TheChatou/lif3d-poc2d/docs/matos/S46a3821951794acbb375fb2ea09c03bbg.png

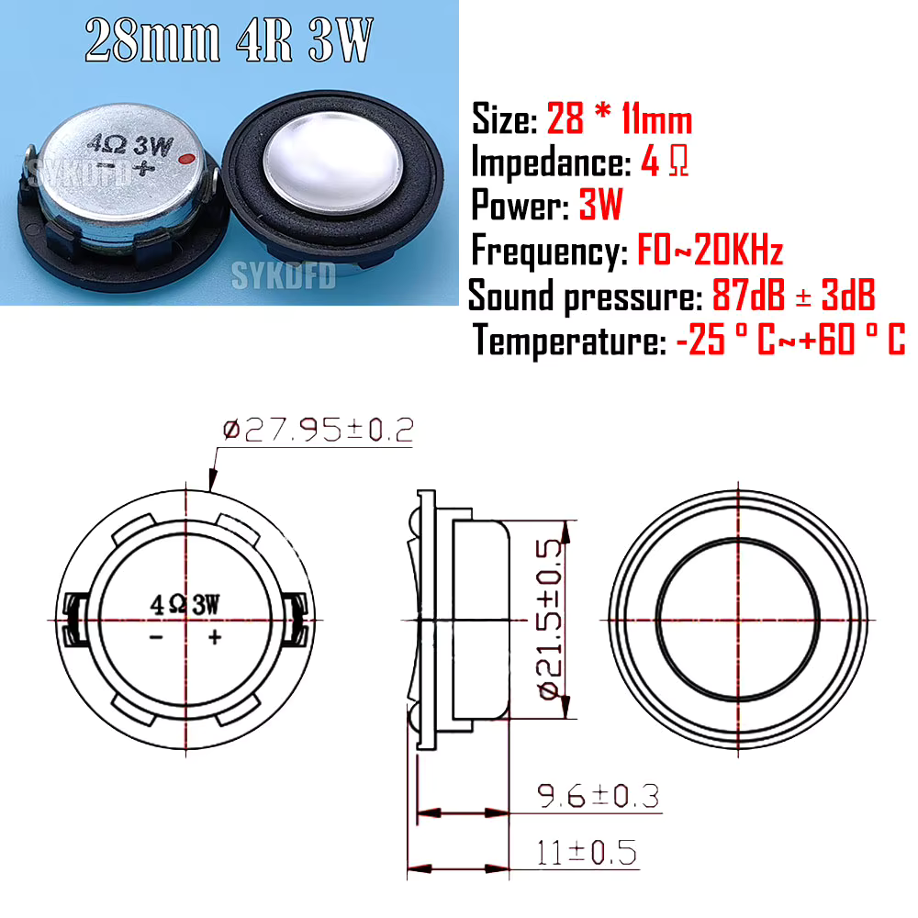
docs/matos/S46a3821951794acbb375fb2ea09c03bbg.png
