TheChatou/lif3d-poc2d/docs/media/photos/20261024_schema_cablage_asbuilt.jpg

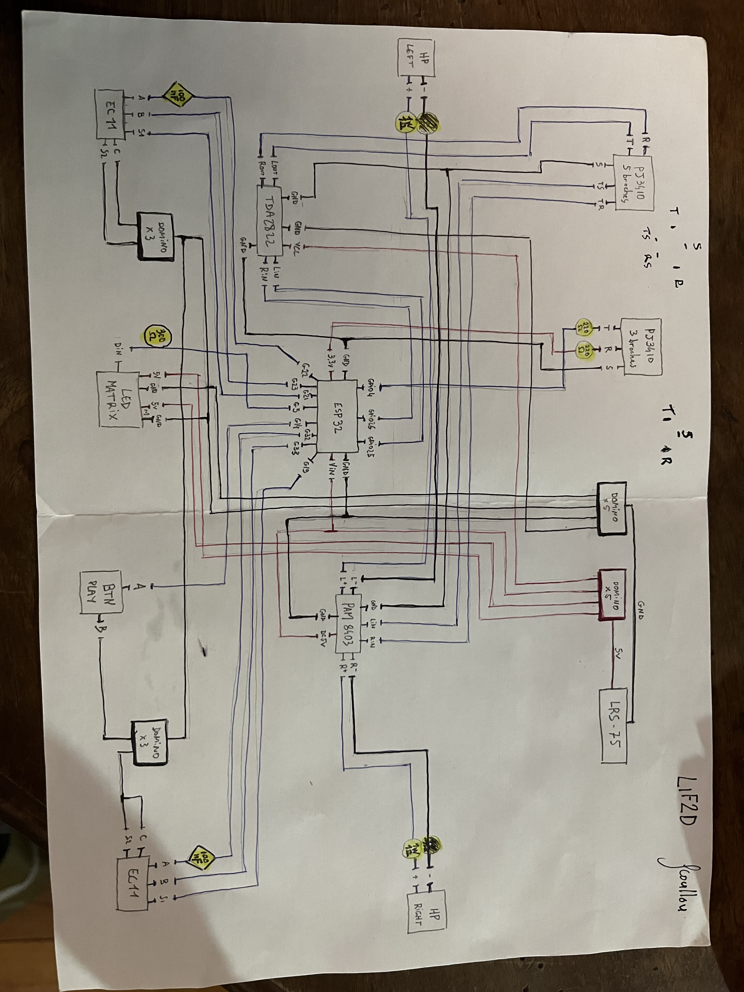
docs/media/photos/20261024_schema_cablage_asbuilt.jpg
