TheChatou/lif3d-poc2d/docs/progress.md

# LIF2D — Journal de progression

---

## 2026-06-02 — Première session lab, setup hardware

**Fait :**
- État des lieux complet du projet (firmware, simulateur, matos)
- Création du skill `/sim` (lance le simulateur depuis Claude Code)
- Création du skill `/log-session` (documente les sessions)
- Correction bug `sim.py` ligne 1013 — `v` parasite causant un IndentationError
- Mise à jour CLAUDE.md : MCU confirmé ESP32-D, hardware reçu listé, gamme Japonaise en priorité, paramètres son validés
- Inventaire hardware : perso (ESP32-D, WS2812B, PAM8403 HW-894 BT5.0, HP 4Ω ×2, alim 12V/2A) + lab (LM2596S)
- Brief fonctionnel rédigé pour Claude Design (`docs/BRIEF_DESIGN.md`)
- Guide de montage complet rédigé (`docs/TUTO_MONTAGE.md`)
- **LM2596S calé à 5.0V** au multimètre — DC Power Supply NANKADF réglé à 12V/1A, multimètre V— range 20V sur OUT+ / OUT−

**Décisions :**
- Utiliser le LM2596S du lab (3A) plutôt que le HX Mini 360 (1.8A) — plus de marge pour les LEDs
- Alimentation tests : DC Power Supply NANKADF (lab) en 12V → LM2596S → 5V, pas le BF-1220 (nécessite adaptateur barrel jack)
- Brief Claude Design : zéro prescription UX, laisser imaginer librement à partir des fonctionnalités + contexte physique

**Prochaines étapes :**
- [ ] Étape 2 — Premier test ESP32-D seul (blink + Serial Monitor)
- [ ] Étape 3 — Premier allumage WS2812B
- [ ] Étape 4 — Test audio PAM8403
- [ ] Lancer Claude Design avec le brief

**Hardware présent au lab :**
ESP32-D, WS2812B 16×16, PAM8403 HW-894, HP 4Ω ×2, alim 12V/2A BF-1220, LM2596S (lab), DC Power Supply NANKADF (lab), multimètre (lab)

---
## 2026-09-14 — FreeCAD merges + config.h finalisé

**Fait :**
- FreeCAD : chanfrein 1mm haut+bas créé proprement sur les 2 caches-boutons (Extrude117/118_zigzag), anciens objets cassés/orphelins nettoyés
- FreeCAD : nouveau support générique 30×45mm créé dans le style de support_pam (sans le cut cylindrique)
- FreeCAD : ouverture du connecteur PJ3412 élargie de 0.1mm (puis annulée sur demande)
- FreeCAD : objet `PJ3411` (hiérarchie App::Part imbriquée, 12 objets) supprimé — invisible/inutile
- FreeCAD : `POWER HOLDER` réparé (sketch source avec cercle+rectangle qui se chevauchaient au lieu d'une silhouette unique — auto-intersection corrigée)
- FreeCAD : `Compound002` "Glissière" fusionné proprement (n'était que compoundé, jamais vraiment fusionné)
- FreeCAD : **`FULL_BOTTOM_pour_impression`** et **`FULL_TOP_pour_impression`** créés — coques + tous les supports internes, chacun 1 seul solide valide, prêts pour export STL/Bambu
- `include/config.h` mis à jour : design final 2 encodeurs (`ENC_A`/`ENC_B`, ex-X/Y) + 1 bouton play/pause confirmé et câblé en dur ; ancien `ENC_VOL` (GPIO16/17/18) et `SW_ONOFF` (GPIO13) supprimés ; résistances/condensateurs documentés en constantes
- Schéma de câblage complet publié en artefact (signal GPIO + alimentation 5V/GND dédiée), mis à jour au fil de la session avec TDA2822, IEC Huaconn, LRS-75-5, MIDI Clock/MIDI IN prévu

**Décisions :**
- Design contrôleurs définitivement tranché : 1 bouton + 2 encodeurs génériques (plus de rôle fixe volume/X/Y), tout le paramétrage via menu sur la matrice LED
- GPIO13, 16, 17, 18 officiellement libérés, ne plus les câbler
- Les 2 pièces FreeCAD à problème étaient réparables sans perte de design (pas besoin de repartir de zéro)

**Problèmes rencontrés :**
- `Part::Boolean` (Fuse/MultiFuse) plante avec `Standard_NullObject` sur certains objets multi-solides (Extrude126/127) — contournement : fusion brute via `Shape.fuse()` + `removeSplitter()` en Python plutôt que la commande GUI
- `POWER HOLDER` et `Compound002` avaient des défauts géométriques non visibles via `isValid()` seul — nécessite `Shape.check(True)` pour les détecter (auto-intersections BOP)
- Décalage d'attache (`AttachmentOffset`) sur un Sketch : le repère local d'une face peut être inversé par rapport au Z global — toujours vérifier le `Placement` résultant, pas juste le signe de l'offset

**Prochaines étapes :**
- [ ] Export STL des deux pièces fusionnées + slicing Bambu
- [ ] Décider si `POWER HOLDER` doit être revu en profondeur ou si la réparation suffit à long terme
- [ ] Continuer `src/controls.cpp` (2 encodeurs + bouton) maintenant que les GPIO sont figés
- [ ] Câbler MIDI IN si le H11L1 est commandé/reçu (voir `docs/analyses/20260911_io_audio_midi_reflexion.md`)

**Hardware présent :** inchangé depuis les dernières sessions (voir mémoire projet `project_hardware.md`) — rien de nouveau reçu cette session, uniquement du travail CAO + firmware/doc.

---
## 2026-10-24 — Hardware terminé, début de la phase software

**Fait (entre le 15/09 et le 24/10, hors sessions Claude) :**
- Chronologie (précisée par Felix) : **août** modélisation à la maison → **fin août / début sept.** au Lab, finalisation modélisation + tests d'impression → **semaine du 14/09** impression de toutes les pièces → **nuit du 18 ou 19/09** soudure et câblage complet (le lendemain : incident matrice) → **départ en woofing** → **~11/10** réception et soudure de la nouvelle matrice → **24/10** reprise, phase software
- **Boîtier LIF2D entièrement assemblé et fonctionnel** (impression, soudure, câblage complet) — terminé avant le départ de Paris
- Le firmware de test (affichage chiffres/texte/glider) tourne déjà sur l'ESP32 — matrice, police 3×5 et boîtier validés visuellement
- Matrice WS2812B **rachetée** (voir incident ci-dessous)
- Schéma de câblage as-built dessiné à la main + photos → `docs/photos/` (renommées `20261024_*`, copies `.jpg` ajoutées)
- Vérification schéma ↔ `include/config.h` : **les 15 connexions ESP32 correspondent** (GPIO 4, 5, 14, 19, 21, 22, 23, 25, 26, 32, 33 + VIN/GND/3.3V/GND). Seul le commentaire de la section AUDIO était obsolète (chaîne DAC → TDA2822 → jack 5 broches → PAM8403) — corrigé
- MIDI OUT confirmé conforme TRS **Type A** (Tip = data GPIO4 via 220Ω, Ring = 3.3V via 220Ω, Sleeve = GND)
- Nouveau document : `docs/analyses/20261024_ui_grammaire_controles.md` (inventaire des gestes, types d'écrans, premier jet des réglages)

**Incident — matrice à moitié morte (retour d'expérience) :**
- Contexte : soudure jusqu'à 4h du matin, matrice qui ne s'allumait pas. Le lendemain, debug au multimètre en touchant (en tremblant) les soudures 5V/GND de la réinjection de courant au centre de la matrice. 5 min après : découverte que le fil DATA n'était pas sur la bonne broche de l'ESP32 — c'était la vraie cause du "rien ne s'allume". Résultat : seule la moitié de la matrice fonctionnait.
- Cause probable : la pointe de touche a ponté un pad 5V avec un pad DIN/DOUT voisin → la LED au milieu de la chaîne a grillé, et comme chaque WS2812B retransmet le signal à la suivante, **toute la suite de la chaîne est morte**.
- Leçons :
  1. **Vérifier d'abord le câblage logique (broche DATA, GND commun) avant de mesurer sous tension** — une erreur de broche ne grille rien, une pointe qui glisse oui.
  2. Mesurer **hors tension** (continuité) dès que possible ; sous tension, utiliser des pinces crocodiles plutôt que des pointes tenues à la main sur des pads serrés.
  3. Ne pas debugger fatigué.
  4. 💡 La vieille matrice est probablement **réparable** : une moitié morte = souvent **une seule LED grillée** à la frontière. Remplacer cette LED (5050, en stock sur AliExpress) ou ponter DIN→DOUT sur elle = matrice de rechange.

**Points hardware à confirmer :**
- ~~Condos 100µF sortie TDA2822~~ → résolu : intégrés au module (2 condos 100µF visibles devant les bornes de sortie)
- Son strident : dépend des volumes réglés sur les potards des amplis — baissés pour l'instant ; tests de gain TDA2822/PAM8403 à faire (étape 5)
- ~~Sortie HP− : symbole hachuré~~ → résolu : erreur de dessin, la résistance 1Ω est bien montée côté + (conforme)
- Affectation exacte A/B/clic de chaque encodeur : à valider avec un test (le sens de rotation s'inverse en logiciel si besoin)

**Décisions :**
- Phase suivante = **software**, en commençant par la conception UI : inventaire des réglages + grammaire de gestes + simulateur **web** fidèle au boîtier (photos + FreeCAD)
- Logique des menus écrite de façon portable pour finir en C++ sur l'ESP32 (une seule source de vérité)
- Test par une personne extérieure : plus tard, une fois la maquette jouable

**Prochaines étapes :**
- [ ] Séance de conception : trancher les questions de `20261024_ui_grammaire_controles.md` §6
- [ ] Compléter l'inventaire des réglages (§5)
- [ ] Simulateur web : rendu du boîtier réel + matrice + 2 molettes + bouton ▶
- [ ] Puis firmware : `controls.cpp` (encodeurs), `menu`, sauvegarde NVS

---
## 2026-10-25 — Premier firmware de test des menus (`ui_test`) sur la boîte

**Fait :**
- Firmware `ui_test` (env PlatformIO séparé, sans son) : modules réutilisables `src/ui/` (polices, affichage, entrées, hub, pages de réglages, BOOM, presets, DIAG) + `test_ui/main.cpp` ; polices générées depuis `tools/fonts_src.py` par `tools/gen_fonts.py`
- Orientation de la matrice validée : `ORIENT_TRANSPOSE = 1` seul (`src/ui/display.cpp`)
- DAC fixé à mi-tension quand il n'y a pas de son → plus d'entrée d'ampli flottante
- Fiche interférences : `docs/analyses/20261025_interferences_leds_audio.md`

**Problèmes rencontrés :**
- ⚠️ **Matrice toute blanche au 1er flash** : FastLED non figé (`^3.6.0`) → nouvel env a pris la 3.10.8. Corrigé : `ui_test` figé sur **FastLED 3.10.3** (version validée). Ajout d'une image de sécurité (1 LED rouge 2 s) + luminosité 20 au démarrage
- ⚠️ **Flash qui échoue + USB qui alimente toute la boîte** : secteur coupé, le 5 V USB ressort par VIN et alimente matrice + amplis → le port s'écroule. **Procédure de flash** : débrancher le fil VIN de l'ESP32 (garder GND), USB pour l'ESP32 seul, secteur pour le reste. Jamais USB + VIN branchés ensemble. Rebrancher VIN pour l'usage autonome
- ⚠️ **Molettes : la rotation ne fait rien** (clics OK). Diagnostic par mouchard série : les broches A (GPIO22, GPIO32) restent à 1 en permanence, seules les B bougent. **Cause : condensateur 100 nF câblé EN SÉRIE sur le fil A** (au lieu d'entre A et GND), sur les 2 encodeurs. **Réparation** : retirer le condo et rejoindre les 2 bouts de fil (Wago/domino, pas besoin de souder) ; le condo est facultatif (décodeur à table = anti-rebond logiciel), sinon le mettre entre A et C (GND) de l'encodeur. En attendant : `ENC_SINGLE_CHANNEL 1` dans `src/ui/input.cpp` (tourner = +1, tourner molette enfoncée = −1) → **remettre à 0 après réparation**
- Bruit audio corrélé à l'affichage des LEDs, surtout sur un HP → matériel (condensateurs / masses), mis de côté (voir fiche)

**Retours UX de Felix :**
- Les pages de réglages en "lignes de LEDs" n'ont pas été comprises (vues figées faute de rotation) → retester une fois la navigation possible ; variante prévue : réglage sélectionné en grand (nom + valeur), lignes en repère discret
- Bilan Felix (fin de session) : "pas mal dans l'ensemble, plus ou moins ce que j'avais en tête". Déplacement dans les presets peu pratique (aggravé par le mode dépannage 1 contact) ; quelques petits bugs ressentis → à lister à la prochaine session

**Réparation encodeurs — précision :** le condensateur est **soudé directement sur la broche A** de l'encodeur (impossible de juste couper un fil + Wago). Options, de la plus simple à la plus propre :
1. **Ponter le condensateur** : souder un petit bout de fil (ou une goutte d'étain) entre ses 2 pattes → il est court-circuité = A relié directement au fil du GPIO. Aucun dessoudage.
2. Dessouder le condensateur, souder le fil du GPIO directement sur la broche A.
3. (optionnel) remettre le condo entre A et C (GND) de l'encodeur.

**Prochaines étapes :**
- [ ] 2026-10-26 : musique dans `ui_test` (Mozzi + grille GoL de l'UI)
- [ ] Soudure des 2 encodeurs (option 1 ci-dessus) puis `ENC_SINGLE_CHANNEL 0`
- [ ] Lister et corriger les petits bugs UI ; améliorer la navigation dans les presets
- [ ] Figer aussi FastLED 3.10.3 dans `env:esp32dev` et `env:led_test` (encore en `^3.6.0`)

---
## 2026-10-26 — Encodeurs réparés, son dans `ui_test`, diagnostic du bruit

**Fait :**
- **Encodeurs réparés** (Felix) : condensateurs 100 nF **retirés**, fil GPIO directement sur la broche A. `ENC_SINGLE_CHANNEL 0` ; sens inversé pour que horaire = descendre / augmenter (`INVERT_A/B 1`). Quadrature propre (4 transitions par cran, aucun rebond vu)
- **Son dans `ui_test`** : Mozzi + `audio.cpp` ajoutés à l'env ; l'horloge du séquenceur fait avancer le GoL (callback par temps) et la tête de lecture ; ▶ = pause/reprise du son ; molette droite = volume (`audio_set_volume`). Pas encore reliés : BPM, gamme, timbre… ; la BOOM n'est pas reliée aux percussions de `audio.cpp`
- **Presets (REC)** déplacés dans `src/ui/ui_rec.cpp` : clic gauche = aperçu du nom, ▶ = charger + lancer, clic droit = sauver (vide) / ANNULER-ECRASER-SUPPRIMER (occupé) ; **saisie de nom** 12 caractères façon borne d'arcade ; molette gauche = case par case, droite = ligne par ligne. Presets en RAM (NVS à l'étape 4)
- **Réglages en 2 temps** : tourner = ligne (blanc chaud), clic droit = éditer (clignote, valeur affichée, effet en direct), clic droit = valider, clic gauche / appui long = annuler-revenir
- **Appui long ▶ = retour au GOL** depuis partout (sauf GOL = graine, DRAW = effacer)
- Toasts longs : défilent en entier au lieu d'être coupés
- **SYS > TEST LED** (NORMAL / NOIR / FIGE / SANS DITHER) pour le diagnostic du bruit

**Diagnostic du bruit** (détail : `docs/analyses/20261025_interferences_leds_audio.md` §5) :
- Ce ne sont **pas** les LEDs, ni l'ESP32, ni le PAM8403, ni le jack : le sifflement reste ESP32 éteint, et **suit la sortie LOUT du TDA2822** quand on inverse LOUT/ROUT
- Remède commandé : **filtre RC 10 Ω + 1000 µF 16 V** sur le VCC du TDA2822 ; plan B : réseau Zobel 4,7 Ω + 100 nF, ou contourner le TDA

**Retours UX de Felix :** menus "pas mal dans l'ensemble" ; mode édition à valider après essai.

**Prochaines étapes :**
- [ ] Poser le filtre RC sur le TDA2822 à réception des composants → réécouter
- [ ] Valider (ou non) le mode édition des réglages
- [ ] Relier BPM / gamme / timbre / BOOM au son
- [ ] Figer aussi FastLED 3.10.3 dans `env:esp32dev` et `env:led_test`

---

## 2026-10-28 — Extras (TRIP / BRICK / PONG), refonte des contrôles, sauvegarde flash, audit

**Fait (tout flashé et compilé, sauf le dernier lot, voir ⚠) :**
- **EXTRA** dans le hub : `TRIP` (visualiseur PLASMA / TUNNEL damier « demoscene » / MANDALA / KALEIDO ; molettes = vitesse, palette, complexité, zoom ; ▶+molette = teinte ; texte brut par-dessus, sans bandeau), `BRICK` (casse-brique avec étincelles, tremblement, feu d'artifice), `PONG` 2 joueurs
- **Contrôles** : appui long sur les 2 molettes = MENU partout (« QUITTER ? » en DRAW / BRICK / PONG, jeu en pause) ; hub : clic gauche = remonter, clic droit = entrer ; DRAW : molette enfoncée + tournée = tracer ; GOL : long gauche = PLUIE, long droit = BOOM OFF/ON ; BOOM : clic = pas, long gauche = piste, long droit = page PAS (VÉLOCITÉ + PROBA, reliées au son)
- **Sauvegarde NVS** (`src/ui/ui_storage.cpp`) : presets REC écrits à chaque sauvegarde/suppression, réglages 2 s après le dernier changement
- **Reverb** : `>> 8` → `/ 256` (cycle limite qui faisait du bruit même en pause)
- **Audit ponytail** → `docs/analyses/20261028_audit_ponytail.md` ; corrigés : n°1 (écrêtage dur `constrain(dry)` supprimé), n°2/3 (verrous entre cœurs : `snap_mux` dans audio.cpp, `live_grid_edit()` + `grid_mux`), n°7 (cast angle TRIP), n°9 (debug série supprimé)
- Analyse son → `docs/analyses/20261028_son_qui_crache_cpu_ou_ampli.md` : le CPU n'est pas en cause ; suspects = saturation analogique des amplis (pont diviseur 10k/1k) + 8 bits
- Vérifié : le logiciel envoie le MÊME son mono aux 2 DAC → déséquilibre G/D = matériel (canal gauche TDA2822)

**⚠ Codé + compilé mais PAS flashé** (boîte débranchée) :
- Âge des cellules → son : SET AUDIO > AGE SON (OFF / VOLUME par défaut / TIMBRE), SET GOL > AGE MAX (1–8)
- Arpège : modes CONVERGE / DIVERGE / PEDALE + SET AUDIO > OCTAVES ARP (1–3)

**Prochaines étapes :**
- [ ] Flasher le dernier lot (VIN débranché, USB) et l'écouter (AGE SON sur OFF = son d'avant)
- [ ] Retours de Felix sur ses tests : extras, contrôles, sauvegarde après extinction, bruit reverb en pause
- [ ] Tests HP : inverser les HP puis les fils DAC→ampli pour confirmer le canal gauche (proposé : réglage SYS « TEST HP G/D », pas encore fait)
- [ ] Audit restant : n°4 (reverb int16), 5 (clic à l'écriture flash ?), 6 (PAN/SWING piste inutiles), 8 (test GoL), 10–15
- [ ] Commiter tout ce travail (rien n'est commité depuis `ef736e9`)

---

## 2026-10-29 — Arpège façon Ableton, POMPE, couleurs des réglages, âge visible

**Fait :**
- Lot du 28/10 flashé et testé (AGE SON, CONVERGE / DIVERGE / PEDALE, OCTAVES ARP)
- **Arpège façon Ableton** (`src/audio.cpp`, `src/ui/ui_pages.cpp`) : STYLE ARP = UP / DOWN / UP DOWN / DOWN UP / CONVERGE / DIVERGE / THUMB (ex-PEDALE) / PINKY / RANDOM / ACCORD / **POMPE** ; RATE ARP en valeurs de note (1/4 … 1/32, T = triolet) ; GATE ARP (durée des notes) ; SWING ARP 0–100 (remplace GROOVE ON/OFF) ; réglage ACCORD (TOUT / TIERCE / QUINTE) pour ARPEGE OFF ou le style ACCORD
- **POMPE** : tiers grave des notes = basse (G), le reste = accord (A), MOTIF POMPE G A / G G A / G G A A / G A A — validée à l'écoute par Felix (« la pompe marche »)
- **SET AUDIO en couleurs par famille** : cyan = musique, vert = son, violet = arpège, orange = batterie (champ `group` de `Setting`)
- Glyphe `/` ajouté à FONT_3X5P (`tools/fonts_src.py` → `gen_fonts.py`)
- Presets AUDIO convertis vers la clé NVS `audio2` (ancien format lu depuis `audio`, aucun preset perdu) ; les réglages courants repartent une fois aux défauts quand `Settings` change de taille
- Commits `768c6de` (code) + `96e1847` (docs)
- **AGE VISU** (SET GOL) : OFF / LUMIERE (cellule vieille = plus sombre, plancher 1/3) / COULEUR (jaune → violet), rythmé par AGE MAX — **flashé, PAS commité, pas encore de retour de Felix**
- Note pédago : `docs/pedago/20261029_musique_arpegiateur.md` (tierce, quinte, thumb/pinky, pompe, rate/gate/swing)
- Navigation : Felix a constaté que clic gauche = retour fonctionne bien → rien changé. PLUIE (long gauche en GOL) expliquée : 12 cellules au hasard pour réveiller la grille

**Prochaines étapes :**
- [ ] Retour de Felix sur AGE VISU (LUMIERE vs COULEUR, lisibilité à faible luminosité) puis commiter
- [ ] Idées en suspens : renommer PLUIE (GRAINES / SEMER ?) ou effet visuel ; double-clic + maintien = retour au GOL ?
- [ ] Tests HP G/D (canal gauche TDA2822), pont diviseur 10k/1k
- [ ] Audit restant : n°4, 5, 6, 8, 10–15

---

## 2026-11-07 — Filtre RC soudé, gros lot UI + audio, dossier V2

**Matériel :**
- Filtre RC 10 Ω + 1000 µF soudé sur le VCC du TDA2822 (+ 100 nF gardé) : sifflement atténué mais pas supprimé. Diagnostic affiné : aigu qui suit l'affichage et le PAM (alim partagée + gain ×100 du TDA), grave constant + ronronnement ~2 Hz (alim LRS en rafales ?), crachotement du potar (tension continue), gauche plus fort potar en bas (pistes du potar)
- Fiche d'atelier (artifact « Code couleur résistances ») : code couleur, montage du filtre RC, **pont diviseur 10 k / 1 k (+ 10 nF)** à souder

**Firmware (flashé, testé partiellement par Felix) :**
- SYS : REDEMARRER, VOIX (4–16, défaut 16), DITHER ; RESET par page (AUDIO / GOL / BOOM) avec confirmation
- SET GOL : familles de couleurs, CURSEUR (COLONNE / LUMIERE / NOTES = notes réellement jouées), 8 palettes (AGE VISU COULEUR propre à chaque palette, LUMIERE plus contrastée)
- SET AUDIO : REPETE ARP (INF), FILTRE + RESO (passe-bas résonant), VOL BOOM supprimé (un seul volume dans SET BOOM)
- REC : CHARGER / ECRASER / SUPPRIMER au clic droit, ▶ = play/pause partout
- Texte en surimpression sur GOL/BOOM ; démarrage en pause ; logo glider vivant + fondus 1 s + mélodie I-vi-IV-V ; image de test rouge supprimée
- DRAW : croix transparente ; appui long 2 molettes annulé si on tourne
- Lignes de réglage mémorisées par page ; BPM max 180
- Audio : limiteur, mixage 16 bits, reverb 16 bits, dither TPDF + noise shaping (`src/audio_out.h`, testé sur PC), kit **STUDIO** échantillonné (`tools/gen_drums.py` → `src/drum_samples.h`), presets BOOM DNB / MINIMAL / TECHNO / PSYTRANCE
- ⚠️ Mozzi réellement installé = **1.1.2** (pas 2.x comme indiqué dans CLAUDE.md)

**Docs :** `docs/analyses/20261107_audio_8bits_v1_et_v2.md`, dossier `docs/v2/` (README, problèmes V1, architecture, plan)

**Prochaines étapes :**
- [ ] Felix teste : kit STUDIO, FILTRE/RESO, DITHER ON/OFF, VOIX 16 (craquements ?), PSYTRANCE (~145 BPM), DNB (~174 BPM)
- [ ] Souder le pont diviseur (fiche d'atelier)
- [x] Lot du 2026-11-07 commité (`300398d`, `72610c7`, `97c951d`)
- [ ] Phase 1 V2 : trancher les questions de `v2/docs/architecture.md` §5 puis `/project-spec`

---

## 2026-11-08 — Notion + réorganisation du dépôt par version

- **Notion** : phases LIF2D 0–7 et LIF3D L1–L2 séparées, colonne Projet, vues LIF2D / LIF3D / Frise ; la Timeline de création (9 actes, images) remplace la colonne de droite de la page principale.
- **Versions** : on parle désormais de V1 (la boîte finie), V2, V3… — plus de « Beta 1 » ni de « POC ». Projet perso, la vente n'est pas un objectif.
- **Réorganisation (tidy, variante « par version »)** : `v1/` (firmware, simulateurs, hardware, docs, archives), `v2/docs/`, `docs/` commun (progress, analyses, pedago, media). Docs LIF3D déplacés vers `../Volumetric_3D/`.
  - `pio` se lance depuis `v1/firmware/` ; `make run` / `make test` toujours depuis la racine.
  - Corbeille : KiCad d'essai, sauvegardes FreeCAD, anciennes versions .3mf, doublons, `LIF2D_CONTEXT_CLAUDECODE.md`, `reccuperation.tx`.
  - Photos HEIC converties en JPG pleine résolution (4032×3024).
  - Vérifié : `pio run` esp32dev / led_test / ui_test OK, `make test` OK.
  - Les anciennes analyses datées gardent leurs anciens chemins (comptes rendus d'époque).

**Prochaines étapes :**
- [x] Réorganisation commitée et poussée
- [ ] Notion : retirer la phase 6 « Produit V2 / petite série » et les tâches de vente non validées
- [ ] Reprendre : tests audio de Felix, pont diviseur, phase 1 V2 (`v2/docs/plan.md`)
