TheChatou/lif3d-poc2d/docs/matos/Capture du 2026-08-24 22-15-57.png

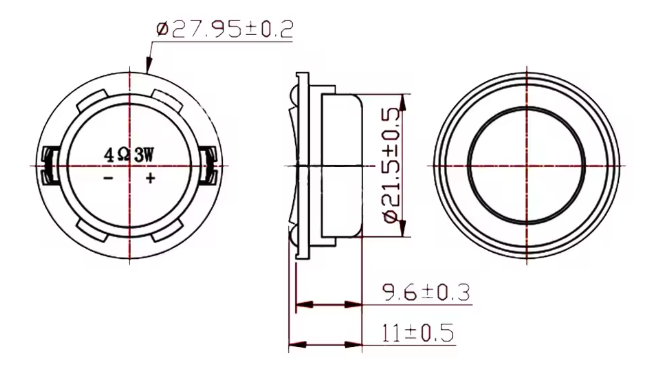
docs/matos/Capture du 2026-08-24 22-15-57.png
