TheChatou/lif3d-poc2d/docs/matos/Capture du 2026-09-04 16-02-42.png

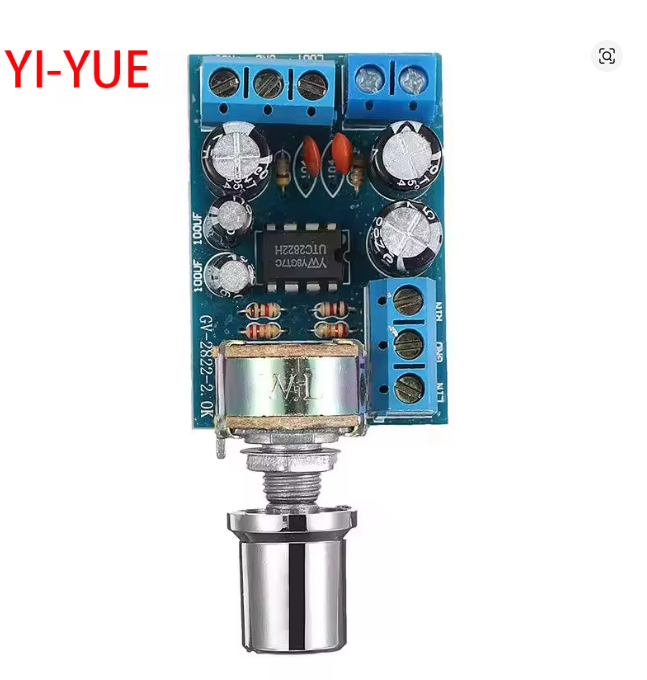
docs/matos/Capture du 2026-09-04 16-02-42.png
