TheChatou/lif3d-poc2d/docs/media/photos/20261024_boitier_dessus_texte.jpg

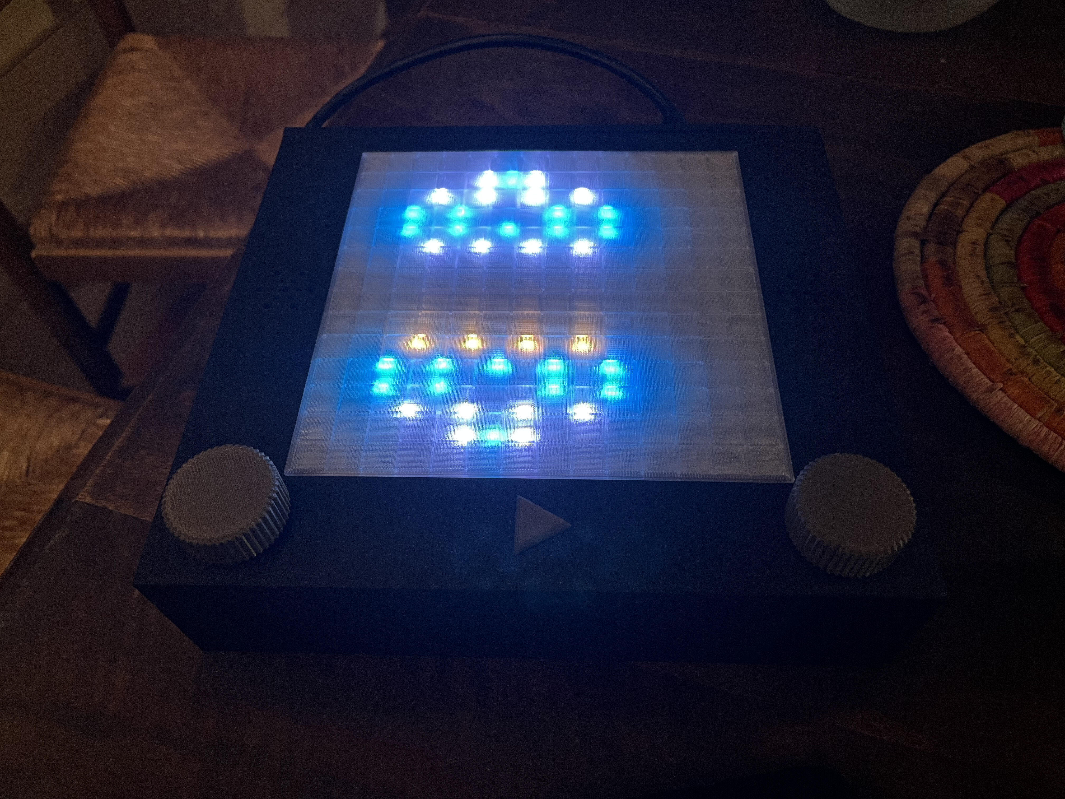
docs/media/photos/20261024_boitier_dessus_texte.jpg
