TheChatou/lif3d-poc2d/docs/media/photos/20261024_freecad_vue_iso.png

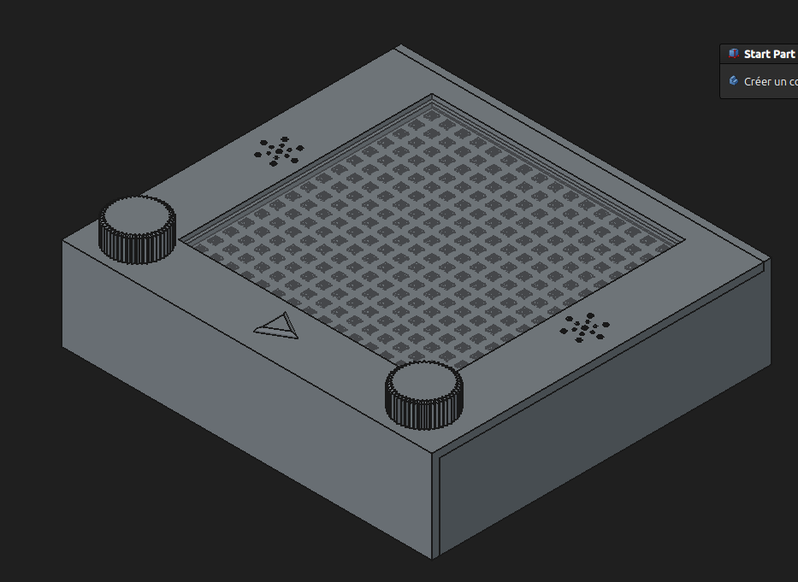
docs/media/photos/20261024_freecad_vue_iso.png
