TheChatou/lif3d-poc2d/docs/media/photos/20261024_interieur_boitier_ouvert.jpg

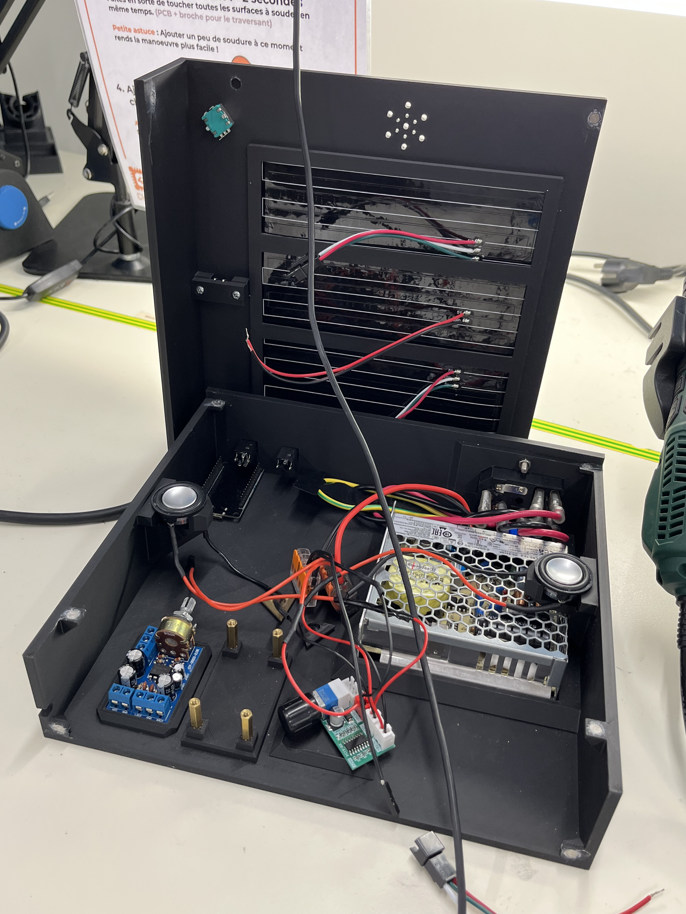
docs/media/photos/20261024_interieur_boitier_ouvert.jpg
