TheChatou/lif3d-poc2d/docs/media/screens/20260412_222818.png

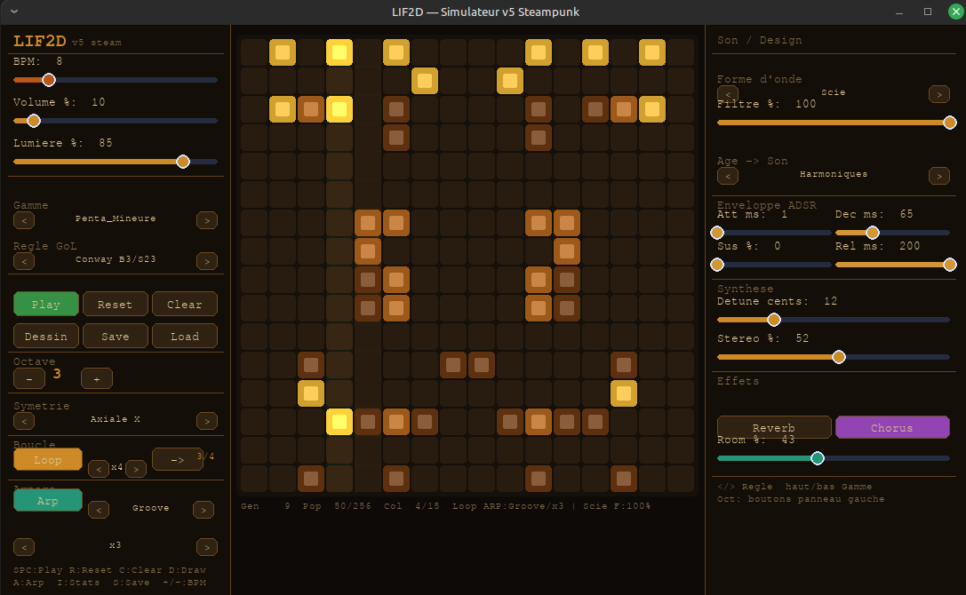
docs/media/screens/20260412_222818.png
