TheChatou/lif3d-poc2d/docs/media/screens/20260602_215519.png

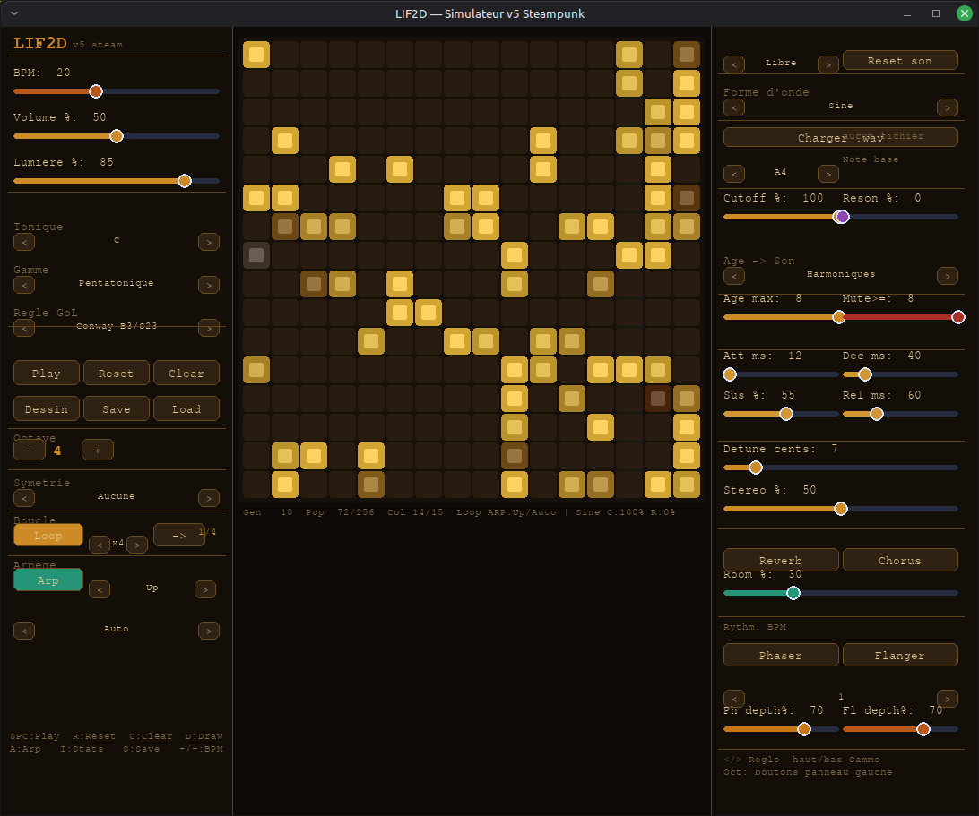
docs/media/screens/20260602_215519.png
