TheChatou/lif3d-poc2d/docs/media/screens/20260602_220416.png

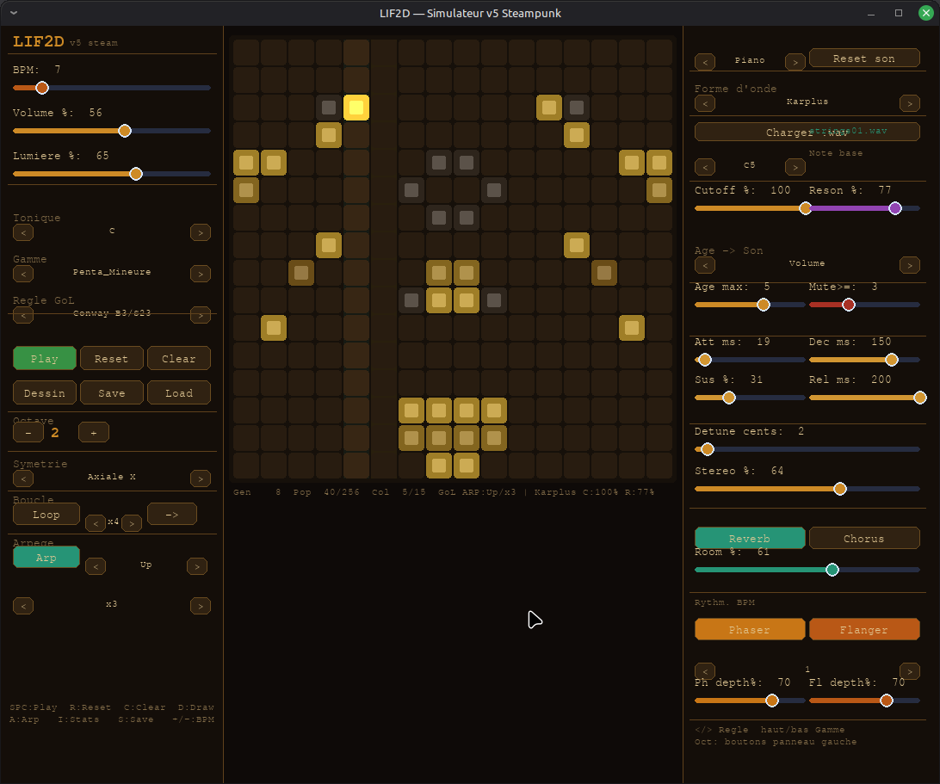
docs/media/screens/20260602_220416.png
