TheChatou/lif3d-poc2d/docs/media/screens/20260603_142304.png

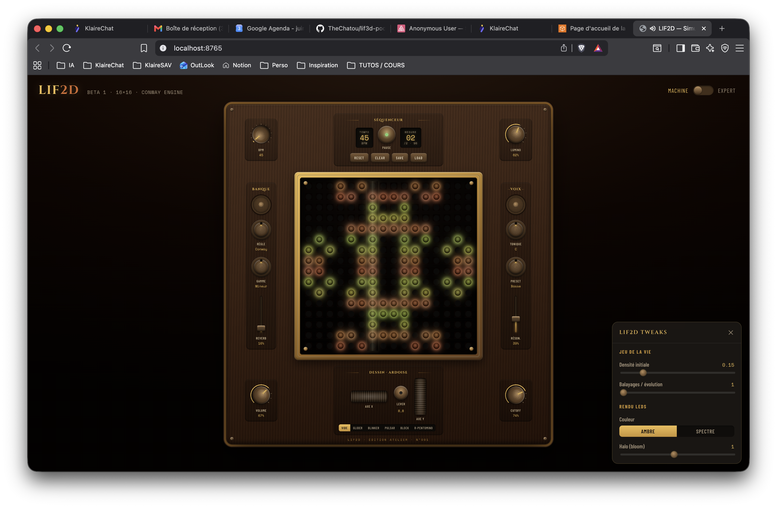
docs/media/screens/20260603_142304.png
