TheChatou/lif3d-poc2d/docs/media/screens/20260607_194520.png

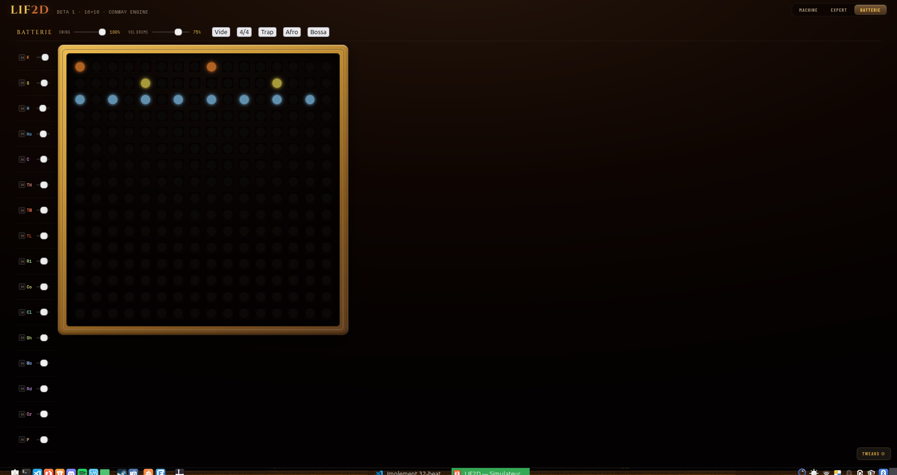
docs/media/screens/20260607_194520.png
