TheChatou/lif3d-poc2d/docs/media/screens/20260607_194553.png

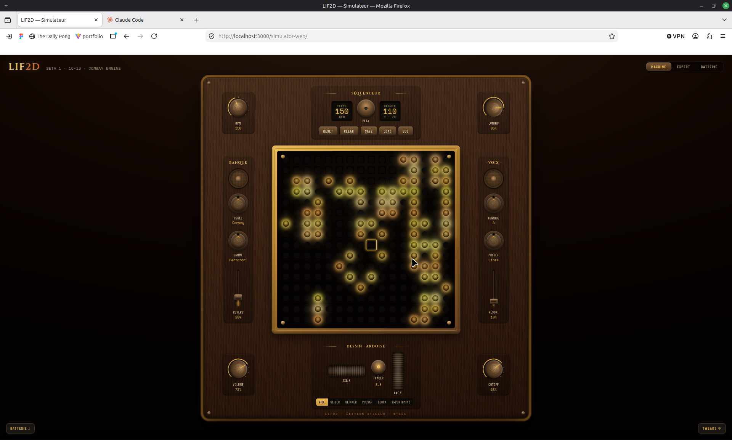
docs/media/screens/20260607_194553.png
