TheChatou/lif3d-poc2d/docs/media/screens/20260613_155504.png

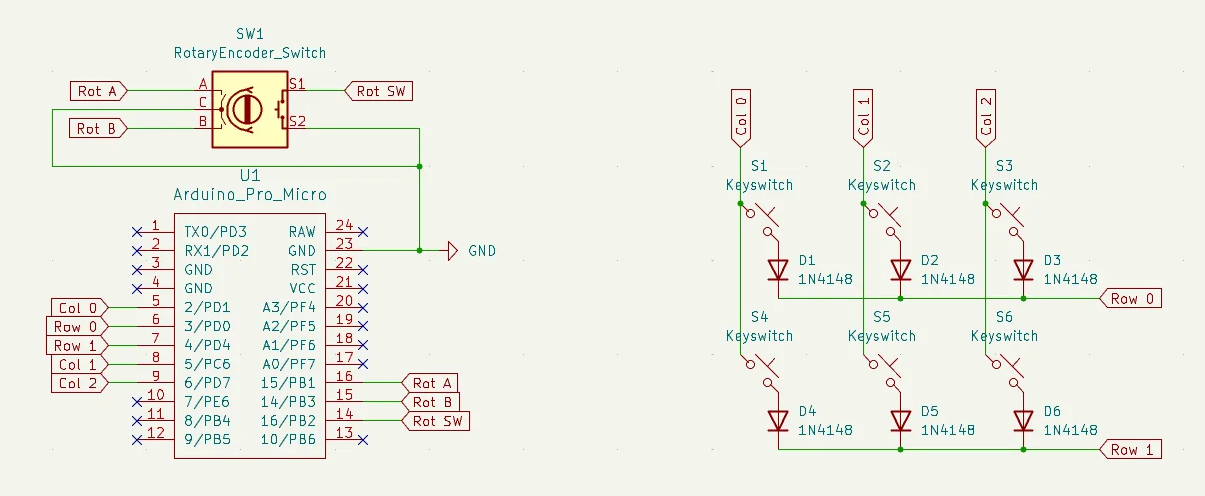
docs/media/screens/20260613_155504.png
