TheChatou/lif3d-poc2d/docs/media/screens/20260825_005327.png

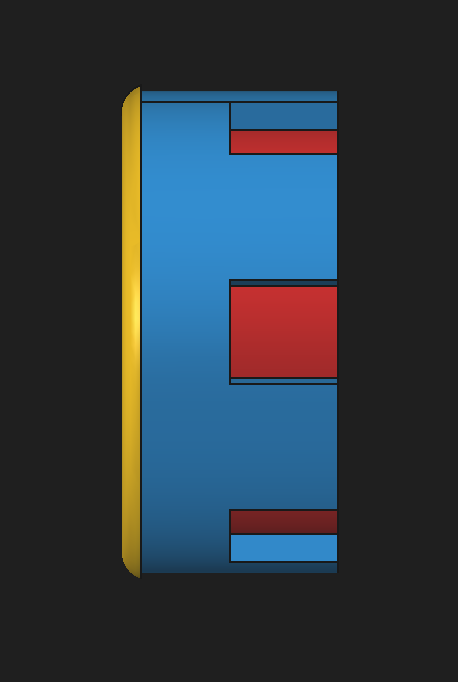
docs/media/screens/20260825_005327.png
