TheChatou/lif3d-poc2d/docs/photos/20261024_schema_cablage_asbuilt.jpg

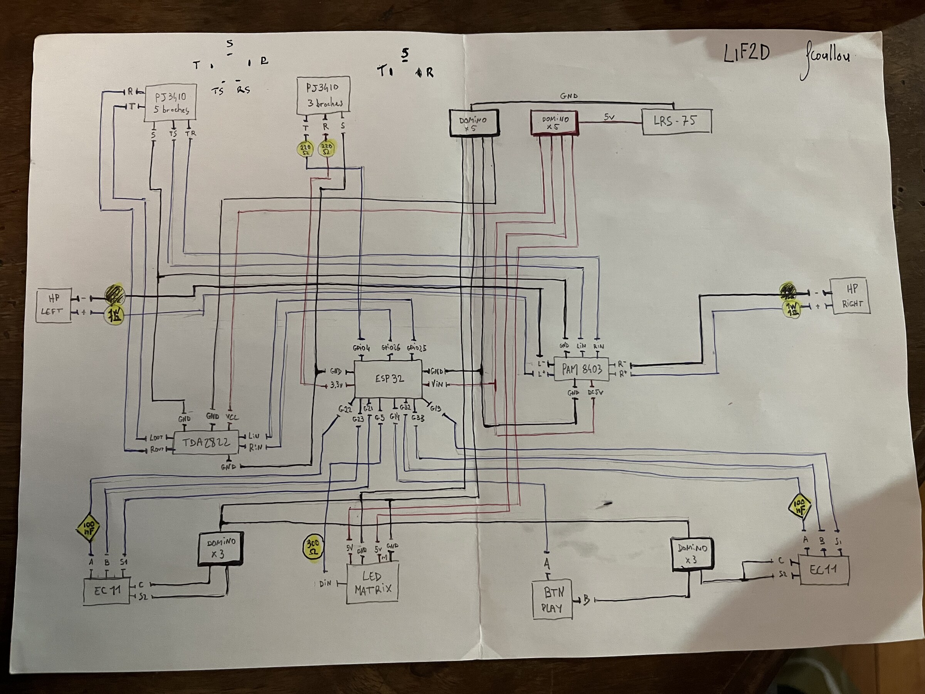
docs/photos/20261024_schema_cablage_asbuilt.jpg
