TheChatou/lif3d-poc2d/docs/screens/Capture du 2026-06-02 22-02-28.png

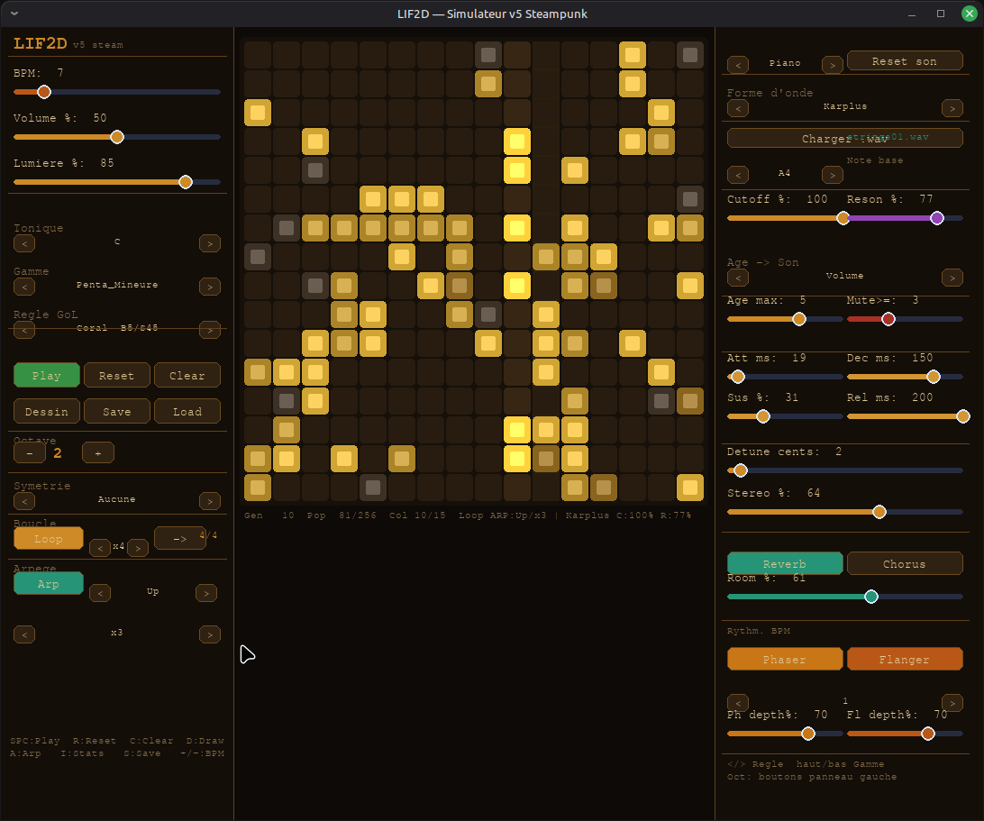
docs/screens/Capture du 2026-06-02 22-02-28.png
