TheChatou/lif3d-poc2d/docs/screens/Capture du 2026-06-09 20-08-08.png

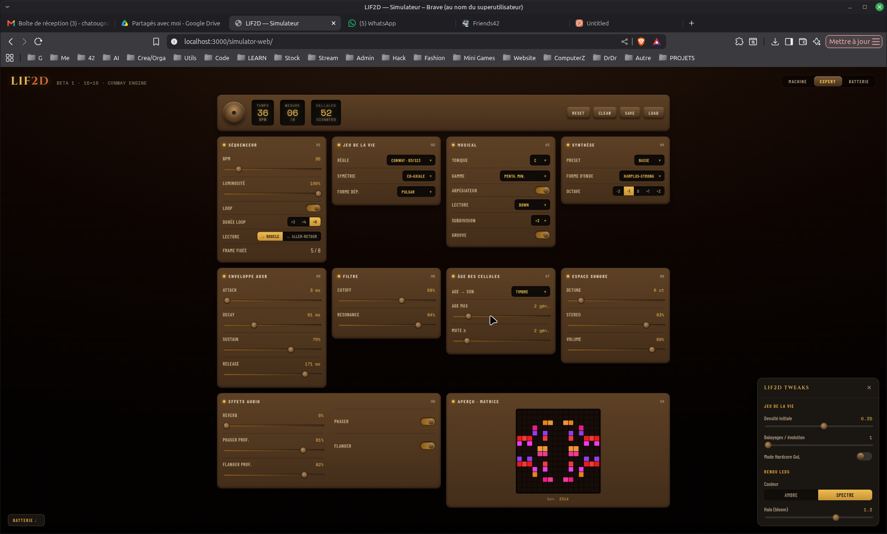
docs/screens/Capture du 2026-06-09 20-08-08.png
