TheChatou/lif3d-poc2d/docs/screens/Capture du 2026-09-14 23-55-55.png

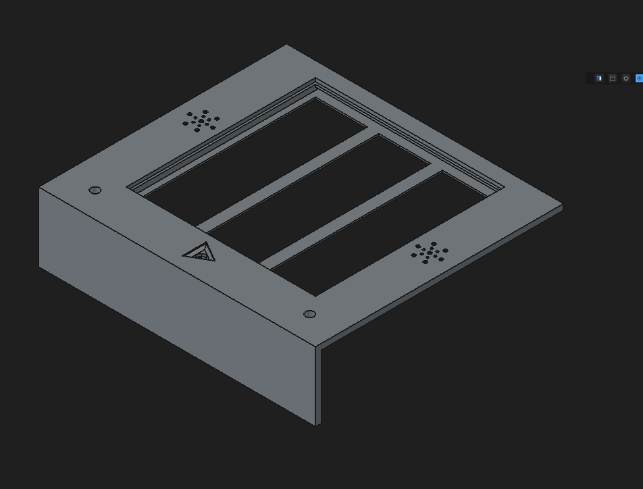
docs/screens/Capture du 2026-09-14 23-55-55.png
