TheChatou/lif3d-poc2d/FreeCad/modeles3d/51bpBJq8r0L._AC_UF1000,1000_QL80_.jpg

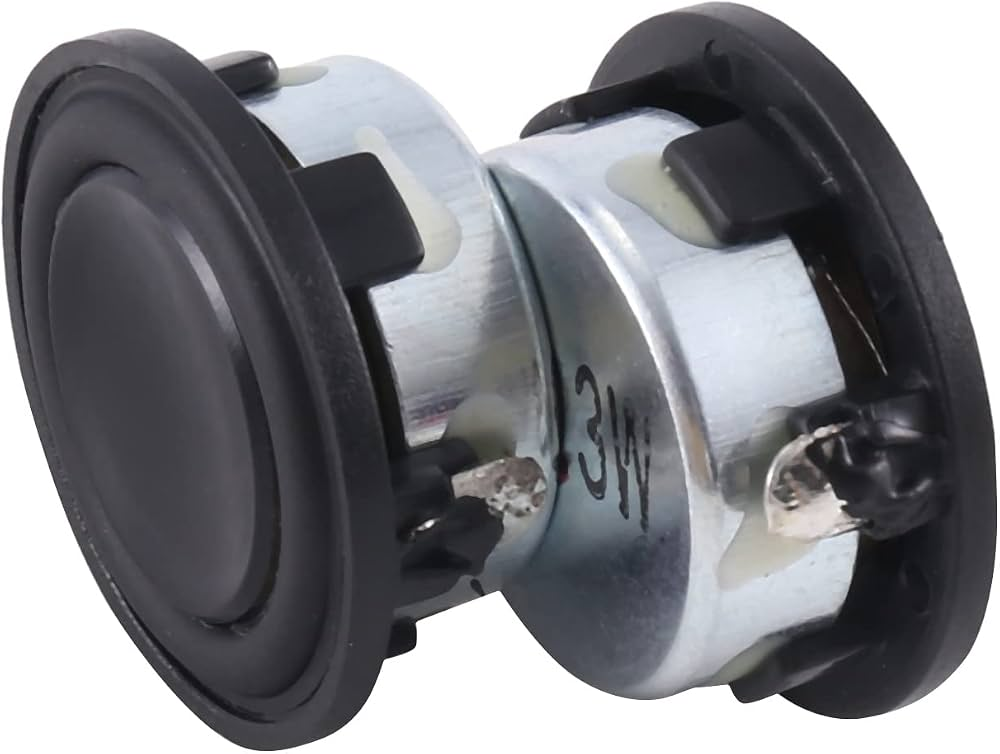
FreeCad/modeles3d/51bpBJq8r0L._AC_UF1000,1000_QL80_.jpg
