TheChatou/lif3d-poc2d/FreeCad/modeles3d/356da3b7-5691-4dd1-ad85-d48ec3c21e43.jpg

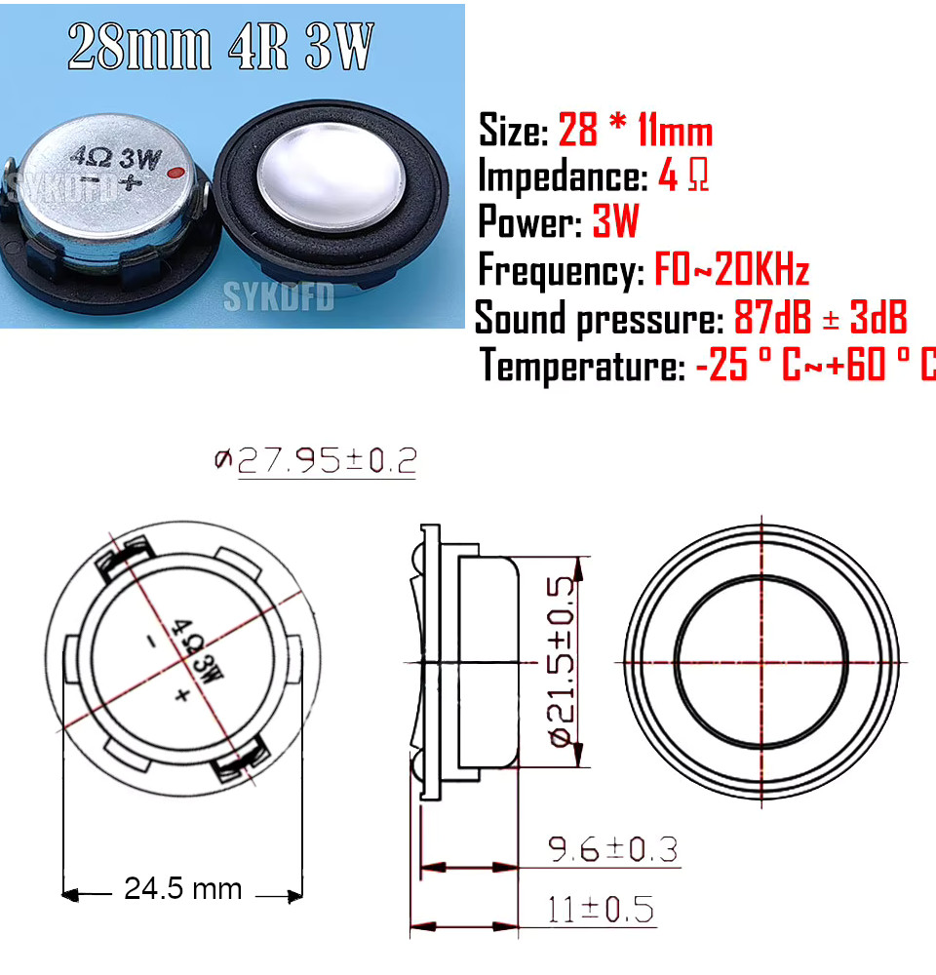
FreeCad/modeles3d/356da3b7-5691-4dd1-ad85-d48ec3c21e43.jpg
