TheChatou/lif3d-poc2d/FreeCad/modeles3d/detail.jpg

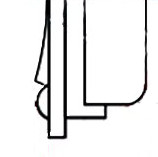
FreeCad/modeles3d/detail.jpg
