TheChatou/lif3d-poc2d/FreeCad/modeles3d/Gemini_Generated_Image_bq7v57bq7v57bq7v.jpeg

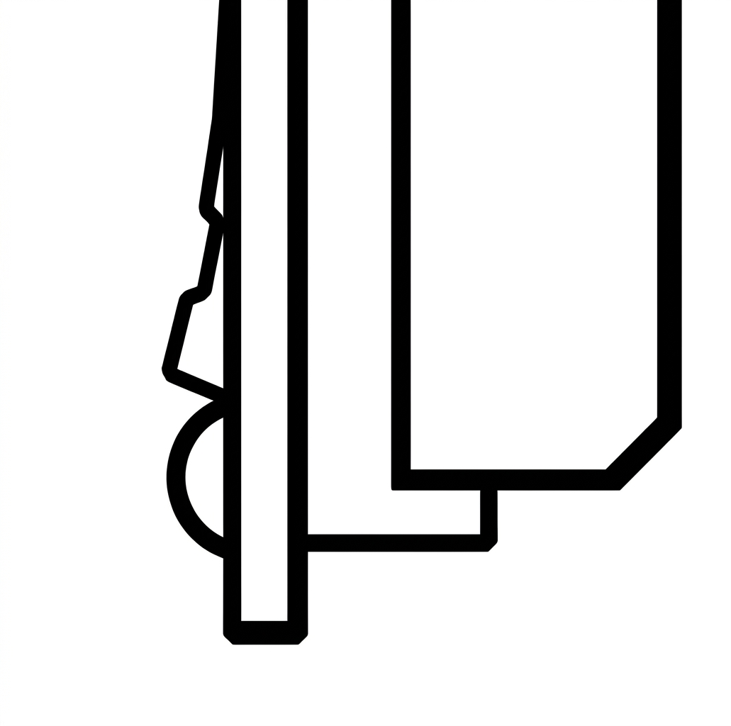
FreeCad/modeles3d/Gemini_Generated_Image_bq7v57bq7v57bq7v.jpeg
