TheChatou/lif3d-poc2d/FreeCad/modeles3d/milimetre.jpg

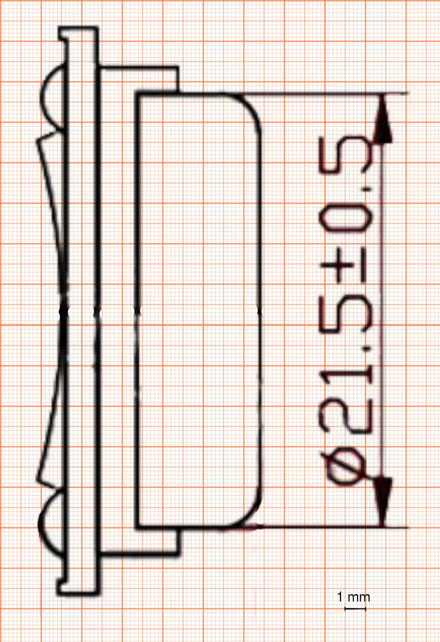
FreeCad/modeles3d/milimetre.jpg
