TheChatou/lif3d-poc2d/FreeCad/modeles3d/push_switch_small.step

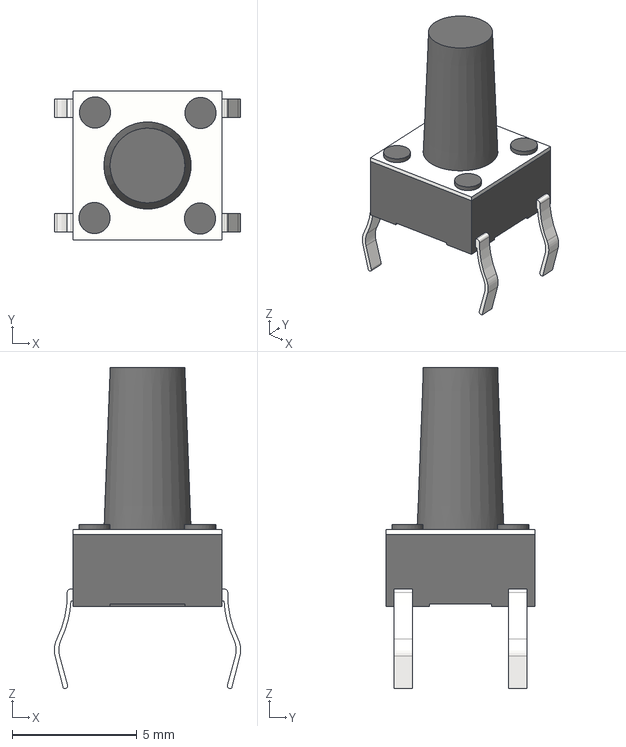
[picture p32: CAD file, 2026-10-24]
FreeCad/modeles3d/push_switch_small.step
7.48 x 6.00 x 12.9 mm
