TheChatou/lif3d-poc2d/FreeCad/tests/LIF2D_WINDOW.3mf

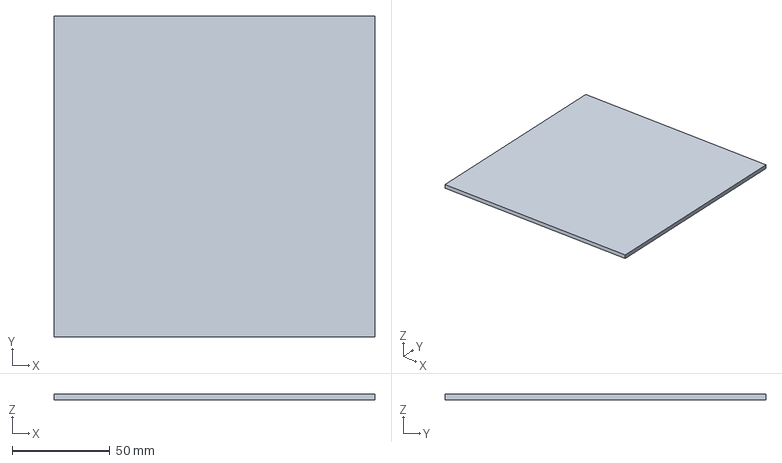
[picture p33: CAD file, 2026-10-24]
FreeCad/tests/LIF2D_WINDOW.3mf
164.0 x 164.0 x 3.00 mm
