TheChatou/lif3d-poc2d/FreeCad/modeles3d/PAM8403 5V 2 Channel USB Digital Audio with Potentionmeter Switch.stp

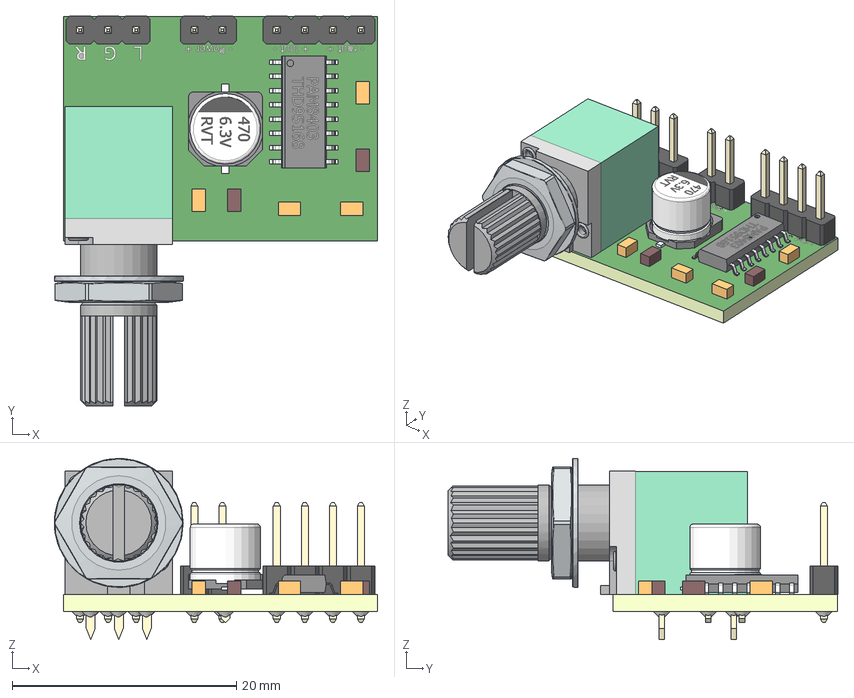
[picture p34: CAD file, 2026-10-24]
FreeCad/modeles3d/PAM8403 5V 2 Channel USB Digital Audio with Potentionmeter Switch.stp
28.8 x 34.7 x 16.1 mm
