TheChatou/lif3d-poc2d/FreeCad/tests/LIF2D_PARTS.3mf

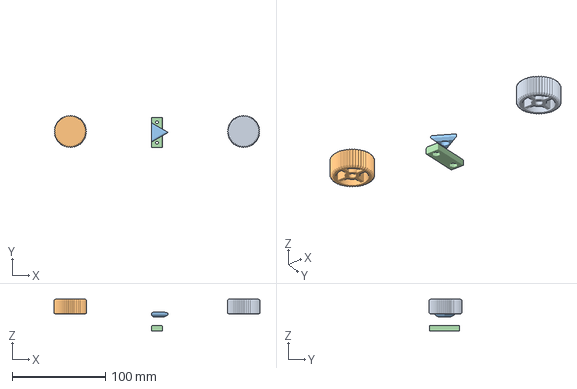
[picture p35: CAD file, 2026-10-24]
FreeCad/tests/LIF2D_PARTS.3mf
221.0 x 35.0 x 34.0 mm
