TheChatou/lif3d-poc2d/FreeCad/modeles3d/matrice_WS2812b_16x16.FCStd

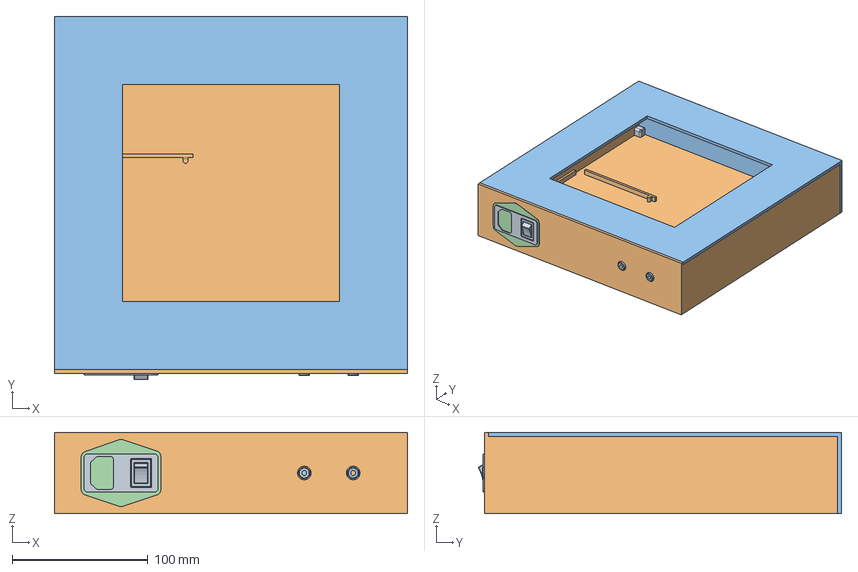
[picture p36: CAD file, 2026-10-24]
FreeCad/modeles3d/matrice_WS2812b_16x16.FCStd
260.0 x 267.5 x 60.0 mm
POWER_PLUG
PJ3410 Body
3.5mm Jack
Pin1
Pin2
Pin3
Pin4
PJ3410 Body001
3.5mm Jack001
Pin001
Pin002
Pin003
Pin004
Aimant
Pattes
Bord
Mousse
Dome
Aimant001
Pattes001
Bord001
Mousse001
Dome001
Hold Magnets
Hold Magnets001
BOTTOM003
TOP002
ProfilPrise
plug_shape
