TheChatou/lif3d-poc2d/FreeCad/tests/LIF2D_test_support_hp_v2.3mf

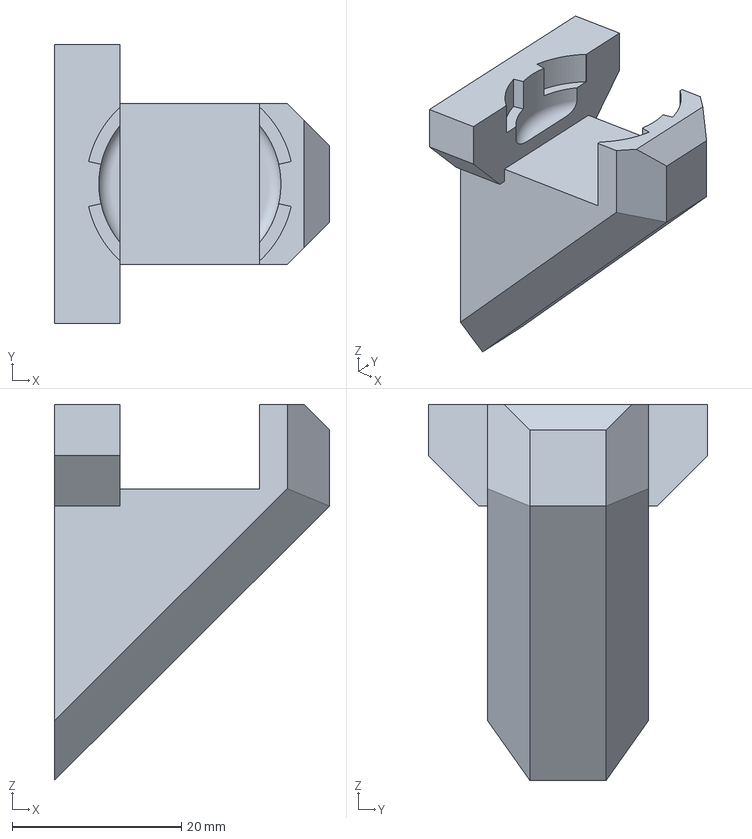
[picture p37: CAD file, 2026-10-24]
FreeCad/tests/LIF2D_test_support_hp_v2.3mf
32.5 x 33.0 x 44.4 mm
