TheChatou/lif3d-poc2d/FreeCad/modeles3d/HP_28mm_v3.step

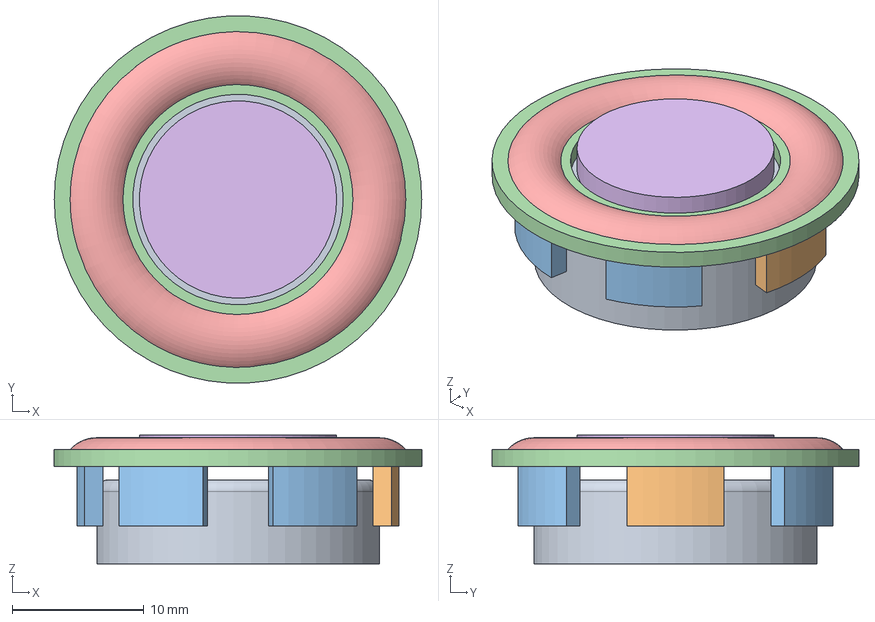
[picture p38: CAD file, 2026-10-24]
FreeCad/modeles3d/HP_28mm_v3.step
27.9 x 27.9 x 9.80 mm
Aimant
Pattes
Bord
Mousse
Dome
