TheChatou/lif3d-poc2d/FreeCad/tests/LIF2D_test_taille_magnet.3mf

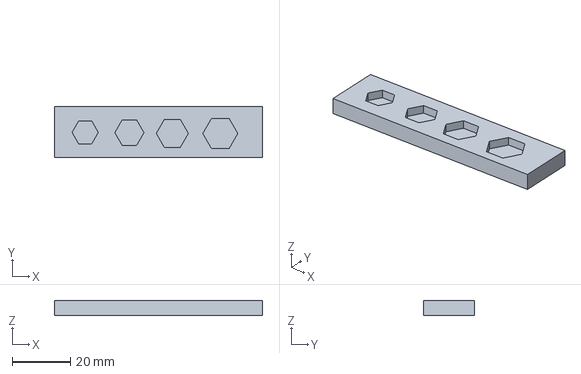
[picture p39: CAD file, 2026-10-24]
FreeCad/tests/LIF2D_test_taille_magnet.3mf
71.2 x 17.6 x 5.00 mm
