TheChatou/lif3d-poc2d/FreeCad/modeles3d/LRS-75-Series(MW).stp

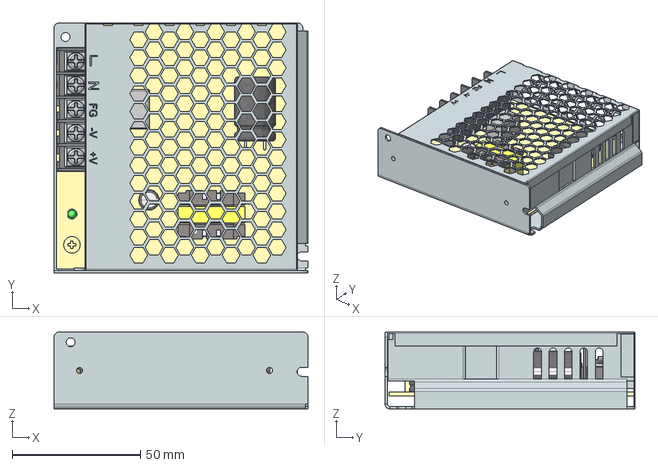
[picture p40: CAD file, 2026-10-24]
FreeCad/modeles3d/LRS-75-Series(MW).stp
99.0 x 97.5 x 30.0 mm
