TheChatou/lif3d-poc2d/FreeCad/tests/LIF2D_test_support_hp.3mf

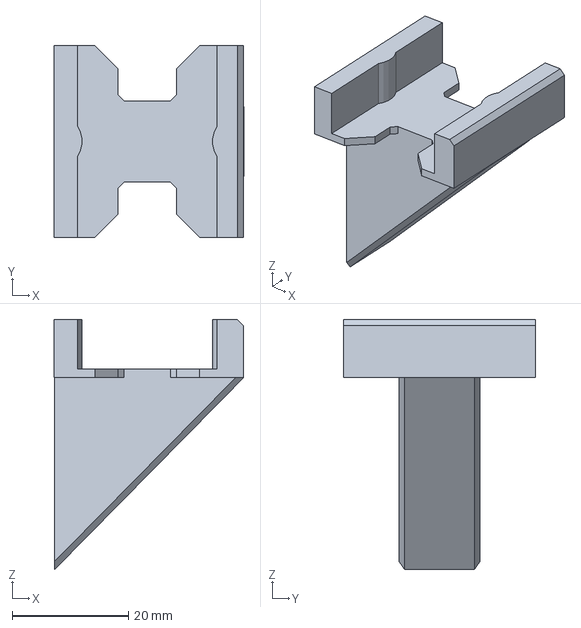
[picture p41: CAD file, 2026-10-24]
FreeCad/tests/LIF2D_test_support_hp.3mf
32.6 x 33.0 x 43.0 mm
