TheChatou/lif3d-poc2d/FreeCad/modeles3d/PAM8403_22x37.step

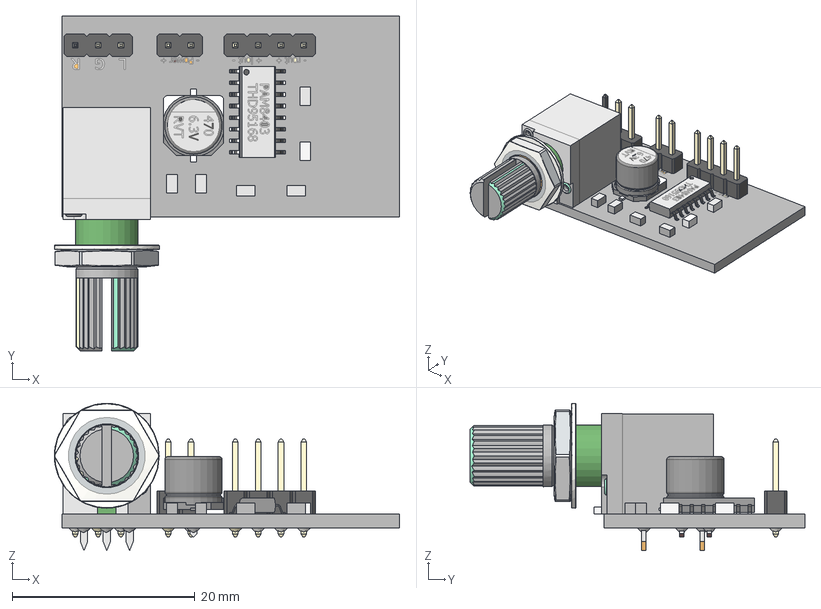
[picture p42: CAD file, 2026-10-24]
FreeCad/modeles3d/PAM8403_22x37.step
37.8 x 36.7 x 16.1 mm
