TheChatou/lif3d-poc2d/FreeCad/tests/LIF2D_test_bouton_v2.3mf

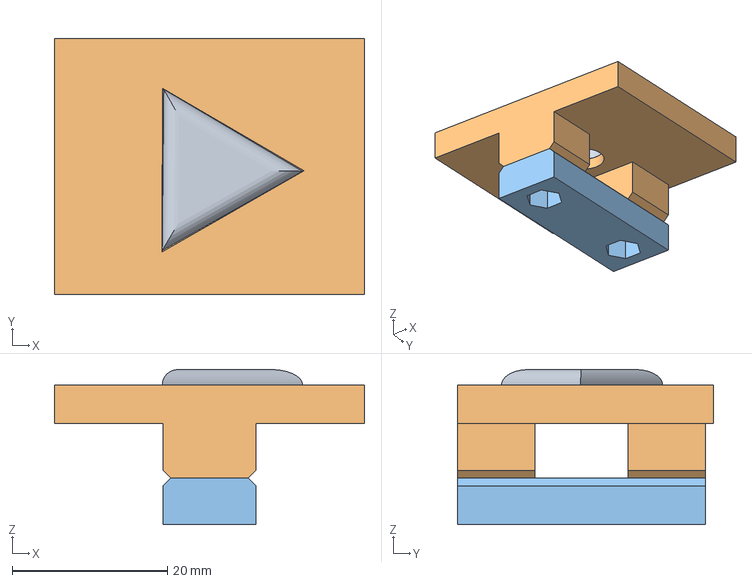
[picture p43: CAD file, 2026-10-24]
FreeCad/tests/LIF2D_test_bouton_v2.3mf
40.0 x 33.0 x 20.0 mm
