TheChatou/lif3d-poc2d/FreeCad/tests/LIF2D_test_jack.3mf

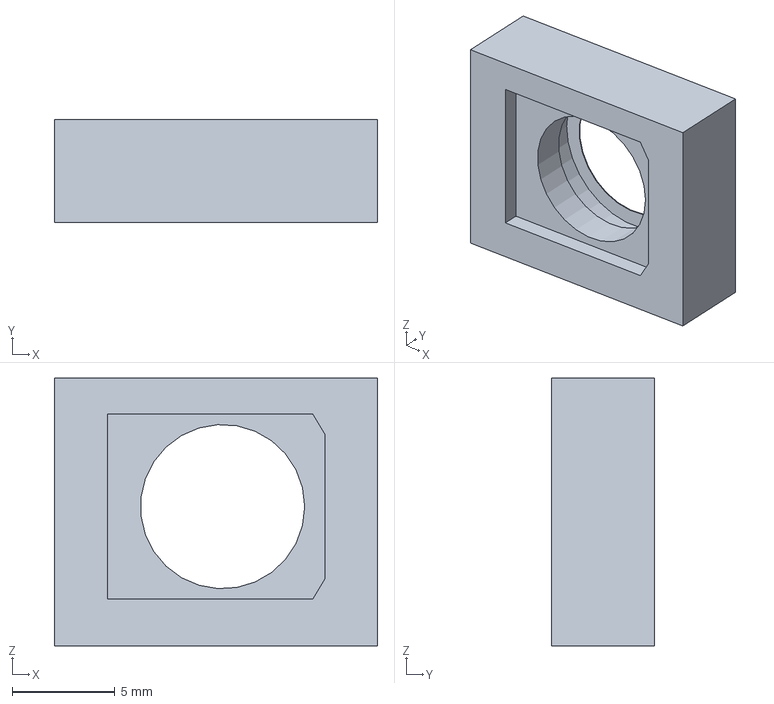
[picture p44: CAD file, 2026-10-24]
FreeCad/tests/LIF2D_test_jack.3mf
15.7 x 5.00 x 13.0 mm
