TheChatou/lif3d-poc2d/FreeCad/modeles3d/PJ3410.step

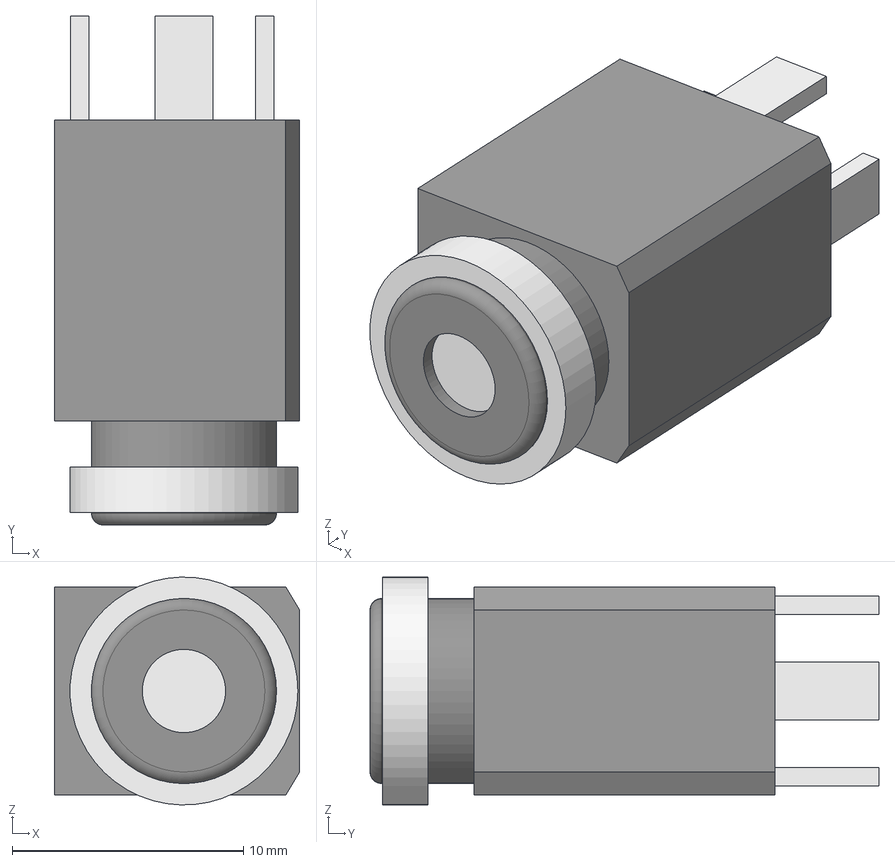
[picture p45: CAD file, 2026-10-24]
FreeCad/modeles3d/PJ3410.step
10.6 x 22.0 x 9.85 mm
PJ3410 Body
3.5mm Jack
Pin1
Pin2
Pin3
Pin4
Nut001
