TheChatou/lif3d-poc2d/FreeCad/modeles3d/parlante_2W.step

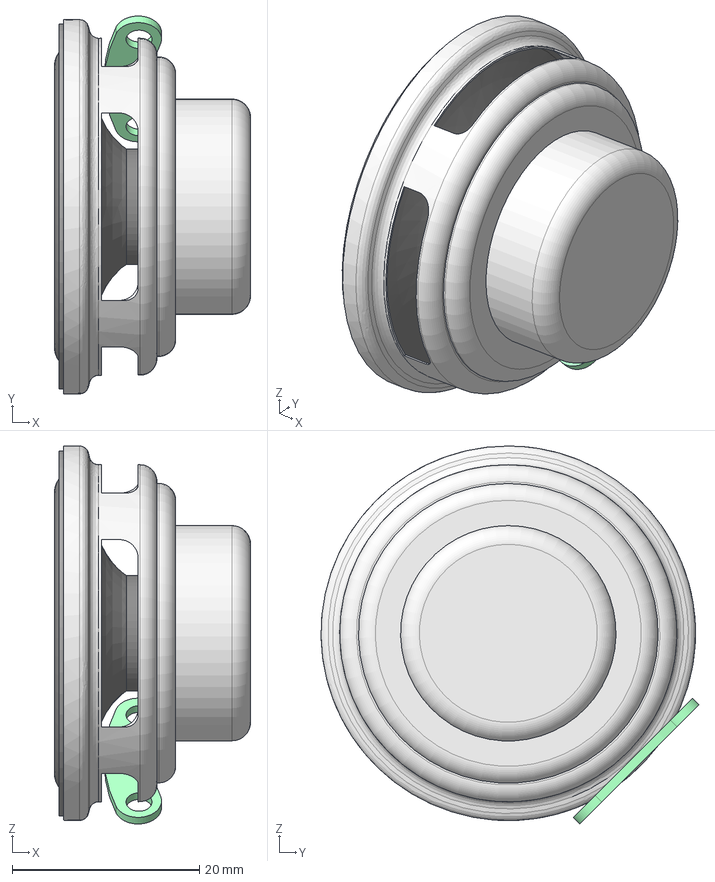
[picture p47: CAD file, 2026-10-24]
FreeCad/modeles3d/parlante_2W.step
21.0 x 40.4 x 40.4 mm
carcasa
Cuerpo
