TheChatou/lif3d-poc2d/FreeCad/tests/LIF2D_PARTS_v2.3mf

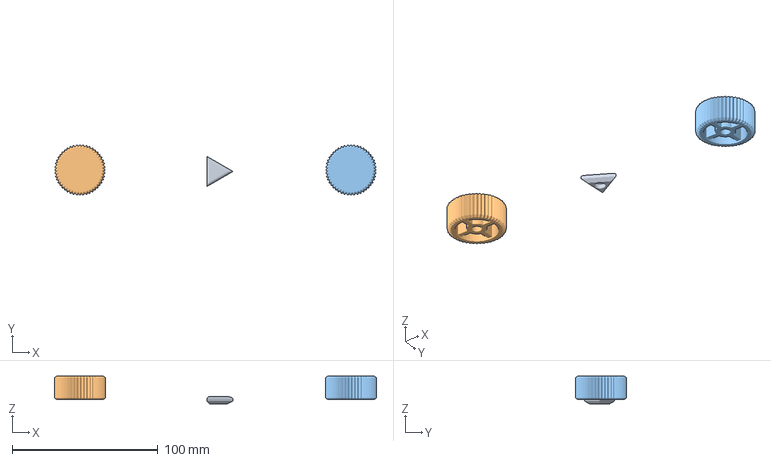
[picture p49: CAD file, 2026-10-24]
FreeCad/tests/LIF2D_PARTS_v2.3mf
221.0 x 35.0 x 19.0 mm
