TheChatou/lif3d-poc2d/FreeCad/tests/LIF2D_BOTTOM.3mf

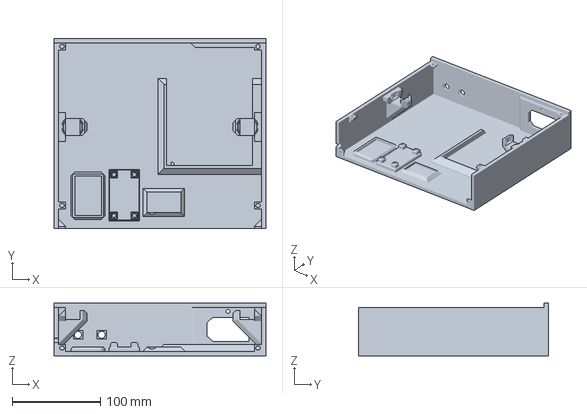
[picture p50: CAD file, 2026-10-24]
FreeCad/tests/LIF2D_BOTTOM.3mf
240.0 x 215.0 x 60.0 mm
