TheChatou/lif3d-poc2d/(list of files, cad)

Other CAD files:
FreeCad/modeles3d/HP_28mm_3w.FCStd
FreeCad/Backups/LIF2D_Box_220x240x50_backup_20260901_175834.FCStd
FreeCad/modeles3d/Huaconn HC-99-F5 switched IEC.ipt
v1/hardware/freecad/composants/bouton_12x12_h12.stp
v1/hardware/freecad/composants/hp_3w_4ohm.step
v1/hardware/freecad/composants/hp_visaton_k2840_3w.stp
v1/hardware/freecad/composants/iec_c14_huaconn_hc99f5.stp
v1/hardware/freecad/composants/pam8403.step
v1/hardware/freecad/composants/ws2812b.iges
v1/hardware/freecad/lif2d_box_220x240x50.FCStd
v1/hardware/impression_3d/boitier_dessous.3mf
v1/hardware/impression_3d/test_bouton.3mf
v1/hardware/impression_3d/test_jack.3mf
v1/hardware/impression_3d/test_molette.3mf
v1/hardware/impression_3d/test_support_tda.3mf
v1/hardware/impression_3d/test_supports.3mf
v1/hardware/impression_3d/test_taille_aimant.3mf
