TheChatou/lif3d-poc2d/src/ui/ui_rec.cpp

#include "ui_internal.h"

// ---------------------------------------------------------------- REC (presets)
// 🎓 Les presets vivent en RAM et sont recopiés en flash (NVS, ui_storage.cpp)
//    à chaque sauvegarde / suppression : ils survivent à l'extinction.
#define SLOTS     16
#define NAME_MAX  12
#define GRID_N   (DISP_W * DISP_H)

struct Slot { bool used; char name[NAME_MAX + 1]; };
struct AudioPreset { int16_t bpm, scale, tonic, octave, timbre, arp, reverb, attack, decay,
                     arp_mode, arp_div, arp_swing, arp_gate, chord, pompe; };

static Slot        slots[3][SLOTS];
static uint8_t     gol_grids[SLOTS][GRID_N];   // 16 × 256 octets = 4 Ko
static int16_t     gol_rules[SLOTS];
static uint32_t    boom_patterns[SLOTS][8];
static AudioPreset audio_presets[SLOTS];

static uint8_t  bank = 0;
static int8_t   slot = 0;
static int8_t   menu = -1;   // -1 = grille ; sinon index dans MENU
static uint32_t menu_t0 = 0;
static const char* const MENU[]       = {"CHARGER", "ECRASER", "SUPPRIMER"};
static const char* const BANK_NAMES[] = {"GOL", "BOOM", "AUDIO"};

static CRGB bank_color() {
    return bank == BANK_GOL ? COL_VISUAL : bank == BANK_BOOM ? COL_BOOM : COL_SOUND;
}

// ---------------------------------------------------------------- formes GoL pré-enregistrées
// 🎓 Les formes célèbres du Jeu de la Vie, rangées dans les premiers slots
//    de REC GOL (règle Conway). Chaque forme = une liste de cellules (x, y).
struct Cell { int8_t x, y; };
static const Cell GLIDER[]   = {{1, 0}, {2, 1}, {0, 2}, {1, 2}, {2, 2}};   // part en diagonale ↘
static const Cell VAISSEAU[] = {{3, 0}, {4, 0}, {1, 1}, {6, 1}, {0, 2}, {0, 3}, {6, 3},
                                {0, 4}, {1, 4}, {2, 4}, {3, 4}, {4, 4}, {5, 4}};   // gros vaisseau, période 4
static const Cell CHAOS[]    = {{0, 0}, {1, 0}, {2, 0}, {0, 1}, {2, 1}, {0, 2}, {2, 2}};  // explose puis oscille
static const Cell RPENTO[]   = {{1, 0}, {2, 0}, {0, 1}, {1, 1}, {1, 2}};   // R-pentomino : longue évolution
static const Cell TOAD[]     = {{1, 0}, {2, 0}, {3, 0}, {0, 1}, {1, 1}, {2, 1}};
static const Cell BEACON[]   = {{0, 0}, {1, 0}, {0, 1}, {3, 2}, {2, 3}, {3, 3}};

// mirror : bit 1 = recopie en miroir gauche/droite, bit 2 = haut/bas
static void stamp(uint8_t* g, const Cell* c, int n, int ox, int oy, uint8_t mirror = 0) {
    for (int i = 0; i < n; i++) {
        int x = ox + c[i].x, y = oy + c[i].y;
        g[y * DISP_W + x] = 1;
        if (mirror & 1) g[y * DISP_W + DISP_W - 1 - x] = 1;
        if (mirror & 2) g[(DISP_H - 1 - y) * DISP_W + x] = 1;
        if (mirror == 3) g[(DISP_H - 1 - y) * DISP_W + DISP_W - 1 - x] = 1;
    }
}

static void preset(uint8_t k, const char* name) {
    slots[BANK_GOL][k].used = true;
    strlcpy(slots[BANK_GOL][k].name, name, NAME_MAX + 1);
    gol_rules[k] = 0;   // Conway
}

#define N(a) (int)(sizeof(a) / sizeof(a[0]))

// 🎓 Presets AUDIO sauvés avant la refonte "Ableton" de l'arpège (clé "audio") :
//    on les convertit au nouveau format au lieu de les perdre.
//    Anciens modes : UP DOWN RANDOM PING TIERCE QUINTE ACCORD CONVERGE DIVERGE PEDALE
static void load_legacy_audio() {
    struct Old { int16_t bpm, scale, tonic, octave, timbre, arp, reverb, attack, decay, arp_mode, arp_div, arp_groove; };
    static const int16_t STYLE[10] = {0, 1, 8, 2, 9, 9, 9, 4, 5, 6};
    static const int16_t CHORD[10] = {0, 0, 0, 0, 1, 2, 0, 0, 0, 0};
    Old old[SLOTS];
    if (!nvs_load("audio", old, sizeof(old))) return;
    for (int i = 0; i < SLOTS; i++) {
        const Old& o = old[i];
        int m = constrain(o.arp_mode, 0, 9);
        audio_presets[i] = {o.bpm, o.scale, o.tonic, o.octave, o.timbre, o.arp, o.reverb, o.attack, o.decay,
                            STYLE[m], o.arp_div, (int16_t)(o.arp_groove ? 70 : 0), 100, CHORD[m], 0};
    }
}

// 🎓 Rythmes d'usine de la BOOM. Une ligne par piste, 32 pas = 2 mesures de
//    doubles-croches ; 'x' = coup, '.' = silence. Lisible comme une grille de
//    boîte à rythmes. Ordre des pistes : KICK, SNARE, HAT, OPEN HAT, CLAP,
//    TOM H, TOM M, TOM L. Le tempo, lui, se règle dans SET AUDIO > BPM.
struct BoomPreset { const char* name; const char* tracks[8]; };
static const BoomPreset BOOM_PRESETS[] = {
    {"DNB", {   // d'après Pocket Operations : mesure 1 "two-step" (DnB 3), mesure 2 "Jungle A" (caisses roulées) — 170-175 BPM
        "x.........x.....x.x.......x.....",
        "....x.......x.......x..x.x....x.",
        "x.x.x.x.x.x.x.x.x.x.x.x.x.x.x.x.",
        "", "", "", "", ""}},
    {"MINIMAL", {   // minimal : kick 4/4, hats clairsemés, "clave" 3-3-2 au tom, clap rare — 122-126 BPM
        "x...x...x...x...x...x...x...x...",
        "",
        "..x.x.x...x...x...x.x.x...x.x.x.",
        "..............................x.",
        "............x...................",
        "",
        "x..x..x...x..x..x..x..x...x..x..",
        ""}},
    {"PSYTRANCE", {   // psytrance : kick 4/4 + "basse roulante" au tom grave sur les 3 doubles-croches après chaque kick (K-B-B-B) — 140-148 BPM
        "x...x...x...x...x...x...x...x...",
        "",
        "xx.xxx.xxx.xxx.xxx.xxx.xxx.xxx.x",
        "..x...x...x...x...x...x...x...x.",
        "............x...............x...",
        "", "",
        ".xxx.xxx.xxx.xxx.xxx.xxx.xxx.xxx"}},
    {"TECHNO", {   // techno : kick 4/4, open hat sur les contretemps, vers 128-135 BPM
        "x...x...x...x...x...x...x...x...",
        "",
        "xx.xxx.xxx.xxx.xxx.xxx.xxx.xxx.x",
        "..x...x...x...x...x...x...x...x.",
        "....x.......x.......x.......x...",
        "", "",
        "...........................x...x"}},
};

static uint32_t steps(const char* s) {
    uint32_t bits = 0;
    for (int i = 0; i < 32 && s[i]; i++) if (s[i] == 'x') bits |= 1UL << i;   // 🎓 bit i = pas i
    return bits;
}

// Rythmes d'usine : remet à jour ceux déjà présents (par leur nom), ajoute les autres dans une case libre
static void add_boom_presets() {
    for (const BoomPreset& p : BOOM_PRESETS) {
        int target = -1, free_slot = -1;
        for (int k = SLOTS - 1; k >= 0; k--) {
            const Slot& s = slots[BANK_BOOM][k];
            if (s.used && !strcmp(s.name, p.name)) target = k;   // déjà là : on remet la version d'usine à jour
            if (!s.used) free_slot = k;
        }
        if (target < 0) target = free_slot;
        if (target < 0) continue;
        slots[BANK_BOOM][target].used = true;
        strlcpy(slots[BANK_BOOM][target].name, p.name, NAME_MAX + 1);
        for (int t = 0; t < 8; t++) boom_patterns[target][t] = steps(p.tracks[t]);
    }
}

static void init_presets() {
    static bool done = false;
    if (done) return;
    done = true;
    memset(gol_grids, 0, sizeof(gol_grids));
    // 🎓 PULSAR : grand oscillateur 13×13 à symétrie parfaite (période 3)
    static const int8_t ARMS[] = {2, 3, 4, 8, 9, 10}, RING[] = {0, 5, 7, 12};
    for (int8_t r : RING)
        for (int8_t a : ARMS) {
            gol_grids[0][(1 + r) * DISP_W + 1 + a] = 1;
            gol_grids[0][(1 + a) * DISP_W + 1 + r] = 1;
        }
    preset(0, "PULSAR");
    stamp(gol_grids[1], GLIDER, N(GLIDER), 1, 1, 1);    preset(1, "GLIDERS");     // paire miroir qui se rencontre
    stamp(gol_grids[2], GLIDER, N(GLIDER), 1, 1, 3);    preset(2, "4 GLIDERS");   // 4 coins → collision au centre
    stamp(gol_grids[3], VAISSEAU, N(VAISSEAU), 1, 5);   preset(3, "VAISSEAU");
    stamp(gol_grids[4], GLIDER, N(GLIDER), 1, 1);       preset(4, "GLIDER");
    stamp(gol_grids[5], CHAOS, N(CHAOS), 6, 6);         preset(5, "CHAOS");
    stamp(gol_grids[6], RPENTO, N(RPENTO), 7, 7);       preset(6, "R-PENTO");
    stamp(gol_grids[7], TOAD, N(TOAD), 6, 4);
    stamp(gol_grids[7], BEACON, N(BEACON), 6, 9);       preset(7, "TOAD BEACON");
    // Une sauvegarde en flash remplace les formes d'usine (elle les contient déjà)
    if (nvs_load("slots", slots, sizeof(slots))) {
        nvs_load("golg", gol_grids, sizeof(gol_grids));
        nvs_load("golr", gol_rules, sizeof(gol_rules));
        nvs_load("boom", boom_patterns, sizeof(boom_patterns));
        if (!nvs_load("audio2", audio_presets, sizeof(audio_presets))) load_legacy_audio();
    }
    add_boom_presets();
}

static void persist() {
    nvs_save("slots", slots, sizeof(slots));
    nvs_save("golg", gol_grids, sizeof(gol_grids));
    nvs_save("golr", gol_rules, sizeof(gol_rules));
    nvs_save("boom", boom_patterns, sizeof(boom_patterns));
    nvs_save("audio2", audio_presets, sizeof(audio_presets));
}

void rec_open(uint8_t b) { init_presets(); bank = b; menu = -1; }

static void save_slot(const char* name) {
    Slot& s = slots[bank][slot];
    s.used = true;
    strlcpy(s.name, name, sizeof(s.name));
    switch (bank) {
        case BANK_GOL:
            memcpy(gol_grids[slot], live_grid(), GRID_N);
            gol_rules[slot] = cfg.rule;
            break;
        case BANK_BOOM: memcpy(boom_patterns[slot], boom_pattern(), sizeof(boom_patterns[0])); break;
        default:
            audio_presets[slot] = {cfg.bpm, cfg.scale, cfg.tonic, cfg.octave, cfg.timbre,
                                   cfg.arp, cfg.reverb, cfg.attack, cfg.decay,
                                   cfg.arp_mode, cfg.arp_div, cfg.arp_swing, cfg.arp_gate, cfg.chord, cfg.pompe};
    }
    persist();
    toast("SAUVE");
}

// ▶ sur un preset : on le charge ET on le lance directement
static void load_slot() {
    const Slot& s = slots[bank][slot];
    switch (bank) {
        case BANK_GOL:
            live_grid_edit([](uint8_t* g) { memcpy(g, gol_grids[slot], GRID_N); });
            cfg.rule = gol_rules[slot];
            break;
        case BANK_BOOM: memcpy(boom_pattern(), boom_patterns[slot], sizeof(boom_patterns[0])); break;
        default: {
            const AudioPreset& a = audio_presets[slot];
            cfg.bpm = a.bpm; cfg.scale = a.scale; cfg.tonic = a.tonic; cfg.octave = a.octave;
            cfg.timbre = a.timbre; cfg.arp = a.arp; cfg.reverb = a.reverb;
            cfg.attack = a.attack; cfg.decay = a.decay;
            cfg.arp_mode = a.arp_mode; cfg.arp_div = a.arp_div; cfg.arp_swing = a.arp_swing;
            cfg.arp_gate = a.arp_gate; cfg.chord = a.chord; cfg.pompe = a.pompe;
        }
    }
    cfg.playing = true;
    toast(s.name);
    nav_open(bank == BANK_BOOM ? SCR_BOOM : SCR_GOL);
}

static void delete_slot() { slots[bank][slot].used = false; persist(); toast("SUPPRIME"); }

static char default_name[NAME_MAX + 1];

static void ask_name(const char* initial) {
    snprintf(default_name, sizeof(default_name), "%s %d", BANK_NAMES[bank], slot + 1);
    name_open(initial, default_name, save_slot);
}

static void menu_handle(const Event& ev) {
    if (ev.type == EV_TURN_A || ev.type == EV_TURN_B) {
        menu = constrain(menu + ev.delta, 0, 2);
        menu_t0 = millis();
    } else if (ev.type == EV_CLICK_A || ev.type == EV_CLICK_B) {
        int8_t m = menu;
        menu = -1;
        if (m == 0) load_slot();
        else if (m == 1) ask_name(slots[bank][slot].name);
        else if (m == 2) confirm_open("SUPPRIMER ?", delete_slot);
    } else if (ev.type == EV_LONG_A || ev.type == EV_LONG_B) {
        menu = -1;
    }
}

void rec_handle(const Event& ev) {
    if (menu >= 0) { menu_handle(ev); return; }
    const Slot& s = slots[bank][slot];
    switch (ev.type) {
        case EV_TURN_A: slot = constrain(slot + ev.delta, 0, SLOTS - 1); break;       // case par case
        case EV_TURN_B: slot = constrain(slot + ev.delta * 4, slot % 4, 12 + slot % 4); break;  // ligne par ligne
        case EV_CLICK_A: toast(s.used ? s.name : "VIDE"); break;
        case EV_CLICK_B:
            if (s.used) { menu = 0; menu_t0 = millis(); }
            else ask_name("");
            break;
        case EV_LONG_A: case EV_LONG_B: nav_back(); break;
        default: break;
    }
}

void rec_render() {
    CRGB base = bank_color();
    if (menu >= 0) {
        draw_label(FONT_3X5P, slots[bank][slot].name, 0, dim(base), true, menu_t0);
        draw_label(FONT_3X5P, MENU[menu], 7, menu == 2 ? CRGB(255, 20, 0) : base, true, menu_t0);
        for (int i = 0; i < 3; i++) disp_set(5 + i * 3, 14, i == menu ? COL_ACCENT : dim(COL_SYS));
        return;
    }
    for (int k = 0; k < SLOTS; k++) {
        int x0 = (k % 4) * 4, y0 = (k / 4) * 4;
        CRGB c = sel_color(base, k == slot);
        if (slots[bank][k].used) {
            for (int d = 0; d < 9; d++) disp_set(x0 + d % 3, y0 + d / 3, c);   // carré plein = enregistré
        } else {
            disp_set(x0 + 1, y0 + 1, c);                                       // point seul = vide
        }
    }
}

// ---------------------------------------------------------------- saisie d'un nom
// 🎓 Comme les "high scores" des bornes d'arcade : la molette fait défiler
//    l'alphabet, un clic ajoute la lettre. Pas de clavier, 2 molettes suffisent.
static const char CHARSET[] = "ABCDEFGHIJKLMNOPQRSTUVWXYZ0123456789- ";
#define CHARSET_N ((int)sizeof(CHARSET) - 1)

static char        name_buf[NAME_MAX + 1];
static uint8_t     name_len = 0;
static int8_t      cand = 0;   // caractère proposé (index dans CHARSET)
static const char* name_fallback = "";
static void      (*name_done)(const char*) = nullptr;

void name_open(const char* initial, const char* fallback, void (*on_done)(const char*)) {
    strlcpy(name_buf, initial, sizeof(name_buf));
    name_len = strlen(name_buf);
    name_fallback = fallback;
    name_done = on_done;
    nav_open(SCR_NAME);
}

void name_handle(const Event& ev) {
    switch (ev.type) {
        case EV_TURN_A: case EV_TURN_B:
            cand = (cand + ev.delta + CHARSET_N * 8) % CHARSET_N;
            break;
        case EV_CLICK_B:
            if (name_len < NAME_MAX) { name_buf[name_len++] = CHARSET[cand]; name_buf[name_len] = 0; }
            else toast("MAX");
            break;
        case EV_CLICK_A:
            if (name_len) name_buf[--name_len] = 0;   // effacer la dernière lettre
            break;
        case EV_CLICK_PLAY: {
            while (name_len && name_buf[name_len - 1] == ' ') name_buf[--name_len] = 0;
            nav_back();
            if (name_done) name_done(name_len ? name_buf : name_fallback);
            break;
        }
        case EV_LONG_A: case EV_LONG_B: nav_back(); break;   // annuler
        default: break;
    }
}

void name_render() {
    CRGB c = bank_color();
    // Nom en cours : s'il dépasse, on montre la fin (les dernières lettres tapées)
    int w = text_width(FONT_3X5P, name_buf);
    if (name_len) draw_text(FONT_3X5P, name_buf, w <= DISP_W ? (DISP_W - w) / 2 : DISP_W - w, 0, c);

    // Lettre proposée en grand au centre, ses voisines en faible sur les côtés
    char cur[2]  = {CHARSET[cand], 0};
    char prev[2] = {CHARSET[(cand + CHARSET_N - 1) % CHARSET_N], 0};
    char next[2] = {CHARSET[(cand + 1) % CHARSET_N], 0};
    if (cur[0] == ' ') for (int x = 5; x < 10; x++) disp_set(x, 13, COL_ACCENT);   // espace = trait
    else draw_text(FONT_5X7, cur, (DISP_W - text_width(FONT_5X7, cur)) / 2, 7, COL_ACCENT);
    draw_text(FONT_3X5, prev, 0, 8, dim(c));
    draw_text(FONT_3X5, next, 13, 8, dim(c));

    // 12 points = 12 caractères max ; le prochain clignote
    for (int i = 0; i < NAME_MAX; i++) {
        CRGB d = i < name_len ? c : dim(c);
        if (i == name_len && (millis() / 300) % 2) d = COL_ACCENT;
        disp_set(2 + i, 15, d);
    }
}
