TheChatou/lif3d-poc2d/(commit log)

2026-04-14 Initial commit — LIF2D simulator + ESP32 firmware skeleton
    - simulator/sim.py : simulateur pygame v5 steampunk (GoL + audio + UI complète)
    - simulator/gol.cpp/h : moteur GoL 2D en C (compilé via build.sh → gol.so)
    - src/ : squelette firmware PlatformIO ESP32 (main.cpp, gol.cpp/h)
    - include/config.h : constantes et pins GPIO
    - docs/ : spec technique complète LIF2D
    - Makefile : commandes run/build/test/profile
    - platformio.ini : config FastLED + Mozzi
2026-06-03 feat: add simulator-web — simulateur steampunk React/Web Audio
    Ajout du simulateur web haute-fidélité (HTML + React 18 + Web Audio API)
    dans simulator-web/, en complément du simulateur Python pygame existant.
    Aucun fichier existant modifié sauf README.md (ajout section simulateur web)
    et .gitignore (ajout simulator-web/node_modules/).
    Fonctionnalités du simulateur web :
    - Boîtier steampunk bois/laiton, layout symétrique 3×3 (vue Machine)
    - Matrice LED 16×16 : halo ambré teinte=note/intensité=âge, flash de lecture
    - Conway B3/S23 synchronisé BPM — 1 génération par balayage exact
    - Arpégiateur : Up/Down/Random/Ping-pong/Tierces/Quintes, subdivisions ×1-×8
    (ternaire ×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
2026-06-05 feat(simulator): samples .wav, filtre biquad cutoff+resonance, marges UI
    - Support sample .wav : chargement overlay pygame-natif, rééchantillonnage
    numpy par note, boucle sustain indépendante de la hauteur
    - Dossier simulator/samples/ avec 6 instruments LMMS convertis (piano,
    flute, violin pizz, bell choir, strings, matrix pluck)
    - Filtre passe-bas biquad 2e ordre (formule RBJ) remplace l'IIR 1er ordre :
    sl_cutoff + sl_resonance côte à côte (effet TB-303 / Moog)
    - Presets Basse (resonance=48%) et Orgue (resonance=22%) mis à jour
    - Fix freeze système : pygame.time.wait(16) dans les boucles overlay Load
    et Charger .wav (boucle tight loop 100% CPU → hard reboot)
    - UI : marges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
2026-06-05 docs(lif2d): update hardware status, validated scales, add docs + blink test
    - CLAUDE.md: mark hardware received (WS2812B, PAM8403, HP, alim 12V/2A),
    add validated Japanese scale + crystal bell params, refresh todo list
    - main.cpp: replace PlatformIO skeleton with LED blink test (first light prep)
    - docs/: add BRIEF_DESIGN, project brief updated, tutorial montage, progress,
    matos photos and sim command reference
    - simulator/patterns: add saved GoL pattern (Dense rule)
    [main.cpp]
2026-06-05 feat: règle docs analyses + compte-rendu roadmap + drum machine web
    - CLAUDE.md : règle — analyses → fichiers docs/analyses/ (pas dans le CLI)
    - docs/analyses/20260605_sim_comparatif_et_roadmap.md : comparatif Python/Web,
    diagnostic perf, design drum-dans-matrice, décisions contrôleurs physiques
    - simulator-web : boîte à rythmes (drums.jsx), mise à jour app.jsx et audio.js
2026-06-05 feat(sim-web): drum matrix mode — 16 tracks, dual view, 5 presets
    - audio.js: add 12 new drum synths (hat ouvert, tom H/M/L, rim, cowbell,
    clave, shaker, maracas, ride, crash, perc); refactor triggerDrum to
    dispatch table (16 instruments + backward-compat 'Tom')
    - drums.jsx: expand to 16 tracks × 16 steps; add 5 rhythm presets
    (Vide, 4/4, Trap, Afro, Bossa); move DRUM_DEFAULT here; compact
    DrumMachine layout (20px rows); export window.DRUM_HUE/DRUM_DEFAULT/DRUM_PRESETS
    - matrix.jsx: dual rendering — GoL mode unchanged, Drum mode shows
    pattern (row=track, col=step, color per track); FlashCells and pointer
    events both drum-aware
    - app.jsx: add drumMode state + ref; paintDrum c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
2026-06-05 feat(sim-web): arp Accord mode, drum volume, Batterie as 3rd view
    - engine.js: add ARP_MODES[6] 'Accord' — all column notes fired
    simultaneously (matches Python sim chord behavior)
    - audio.js: add drumVolume (default 0.75) to state; drumMaster.gain
    now independent from master (GoL) gain; synced via setParams
    - controls.jsx: add ViewTab component (3-way segmented toggle) to
    replace binary Machine/Expert toggle
    - drums.jsx: add BatterieView — full-page drum view with swing,
    drum volume slider, preset pills, and 16-track DrumMachine;
    export window.BatterieView
    - app.jsx: add drumVolume to DEFAULT; sync to audio; add 'batterie'
    to view state; replace Toggle with ViewTab (Machine|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
2026-06-05 feat(web): BatterieView with full 16×16 drum matrix + track labels panel
    Replace slide-up drawer with a proper 3rd view tab (Batterie).
    BatterieView now shows the 16×16 Matrix in drum mode as central element,
    with a left panel (96px, CSS grid 16 rows) for mute/abbr/vol per track,
    aligned pixel-to-pixel with matrix rows.
2026-06-08 feat(sim-web): BPM 60/20-140, mode Hardcore par défaut, harmoniques d'âge, loop rolling-history, accords symétrie+fixes
    - BPM séquenceur : défaut 60, plage 20-140 (machine.jsx, expert.jsx, app.jsx)
    - Mode Hardcore GoL : évolution synchronisée au tempo plutôt qu'au balayage,
    activé par défaut à 1 temps/évolution (le plus chaotique)
    - Âge des cellules → timbre/harmoniques réellement câblé dans la synthèse
    (audio.js : harmonicPartials, triggerOsc multi-oscillateurs)
    - Phaser/Flanger : LFO synchronisés au BPM (mesure = 4 temps) au lieu de
    fréquences fixes indépendantes du tempo
    - Modes Tierce/Quinte de l'arpégiateur convertis en véritables modes
    d'accord : détect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
2026-07-01 feat(firmware): GoL render loop, FastLED serpentine mapping, audio scaffold
    - main.cpp: GoL step loop with serpentine LED index, age-based color, glider seeds
    - gol.h: updated GoL engine interface
    - audio.h/cpp: Mozzi audio module scaffold
    - config.h: GPIO, power and timing constants updated
    - platformio.ini: dependencies aligned
2026-07-01 docs: add CDC, analyses, pedago notes, datasheet and project state update
    - CDC_LIF2D_Beta1_20260611.md: validated hardware spec v1.0
    - analyses/: power budget, WS2812B project references, cable sizing
    - pedago/: electronics/power, ESP32 GPIO, audio/MIDI, cable voltage drop
    - datasheet/: ESP32-D board reference
    - simulator-web/: design assets and music-styles.js
    - CLAUDE.md: updated project state (LRS set to 5V, wiring decisions)
2026-10-24 feat(firmware): add play/pause controls, extend audio engine, align config with as-built wiring
2026-10-24 feat(cad): add FreeCAD enclosure model, component STEP files and KiCad project
2026-10-24 docs: add as-built photos, wiring analyses, pedago notes and software phase roadmap
2026-10-24 feat(ui): add menu system and ui_test firmware for on-box testing
    - src/ui: pixel fonts, framebuffer display, encoder/button events, 2-level hub,
    settings pages, BOOM grid, presets, DIAG screen
    - env:ui_test (no sound) with FastLED pinned to 3.10.3
    - tools/gen_fonts.py generates font tables from tools/fonts_src.py
    - temporary single-channel encoder workaround (pin A capacitor wired in series)
2026-10-25 feat(ui): add sound, preset naming, two-step settings edit and LED noise test
    - Wire Mozzi audio into ui_test: sequencer clock drives GoL and playhead,
    play/pause and volume linked to the audio engine
    - Move presets to ui_rec.cpp: name preview, play to load, 12-char name entry
    - Settings: right click edits/validates, left click or long press cancels
    - Long press on play returns to the running GOL from any screen
    - Re-enable full quadrature decoding after encoder repair, clockwise = positive
    - Add SYS > TEST LED modes (black, frozen, no dither) for noise diagnosis
2026-10-25 docs: record audio noise diagnosis and session log
    Elimination tests trace the whine to the TDA2822 left channel, not the LEDs.
    Add RC supply filter plan, pedagogy notes and roadmap updates.
2026-10-25 feat(audio): run Mozzi on core 0, add arp modes and anti-clipping mix
    - Move audioHook() to a FreeRTOS task pinned on core 0 so FastLED.show()
    can no longer starve the DMA buffer; params passed via spinlock mailbox
    - Saturate reverb comb/allpass buffers, halve reverb input and drum gain,
    add headroom and soft clipping on the final mix
    - Add arpeggiator mode, speed and groove settings (SET AUDIO + presets)
    - Docs: pedagogy notes on overflow/clipping and audio task, CLAUDE.md status
2026-11-07 docs: add screenshots, product sheets, ESP32 datasheet and FreeCAD backup
2026-11-07 feat(audio): add 16-bit mix with limiter, dither, resonant filter and sampled STUDIO kit
    Also adds up to 16 voices, arp hold (REPETE INF), played-rows tracking
    and the boot jingle.
2026-11-08 refactor: reorganize repository by version (v1/, v2/, shared docs/)
    - Move firmware (PlatformIO), simulators, hardware and V1 docs under v1/
    - Move V2 preparation docs to v2/docs/, keep shared docs/ (progress, analyses, pedago, media)
    - Rename screenshots, datasheets, 3D models and print files to snake_case
    - Convert HEIC photos to full-resolution JPG
    - Drop KiCad trial, FreeCAD backups, superseded .3mf versions and duplicates
    - Move LIF3D-only documents out of the repo
    - Update build.sh, platformio.ini, Makefile, .gitignore, README and CLAUDE.md paths
